akcase18/MQB_Monitor_Hardware/bom_production/MQBMonitor_v5.0.2_bom.csv

Designator | Footprint | Quantity | Value | LCSC Part #
C1, C12, C13, C17, C18, C21, C6, C9 | 0402 | 8 | 0.1uF | C1525
C10, C11, C2, C3 | 0603 | 4 | 10uF | C96446
C14, C15, C19, C20 | 0402 | 4 | 10uF | C15525
C16 | 0402 | 1 | 1uF | C52923
C4 | 1206 | 1 | 10uF | C13585
C5 | 0603 | 1 | 0.1uF | C14663
C7, C8 | 0805 | 2 | 22uF | C45783
D1, D2 | D_SMA | 2 | Diode | C8678
D3 | SOT95P230X110-3N | 1 | PESD1CAN,215 | C15771
IC1 | SOT95P280X100-5N | 1 | PAM2804AAB010 | C71463
J1 | AFC01S50FCA00 | 1 | AFC01-S50FCA-00 | C262676
J2 | JST_XH_B4B-XH-A_1x04_P2.50mm_Vertical | 1 | 4-Pin to Car | N/A
L1 | 1008 | 1 | 4.7uH | C5832360
L2 | L_Changjiang_FNR5040S | 1 | 15uH | C167969
R1 | 0402 | 1 | 100k | C25741
R10, R11, R12, R7, R8 | 0402 | 5 | 10k | C25744
R2 | 0603 | 1 | 1R | C22936
R3 | 0603 | 1 | 10R | C22859
R4, R5 | 0402 | 2 | 5.1k | C25905
R6 | 0402 | 1 | 51k | C25794
R9 | 0603 | 1 | 1k | C21190
S1, S2 | SW_PTS526_SM08_SMTR2_LFS | 2 | Push Button | C2689521
U1 | U_SOT-23_TEX | 1 | PLMR54410DBVR | C3200265
U2 | SOT-223-3_TabPin2 | 1 | AMS1117-3.3 | C6186
U3 | ESP32-S3-WROOM-1 | 1 | ESP32-S3-WROOM-1 | C2913205
U4 | SOIC-8_3.9x4.9mm_P1.27mm | 1 | SN65HVD230 | C12084
USB1 | USB_C_Receptacle_G-Switch_GT-USB-7010ASV | 1 | USB-C Port | C2988369
