akcase18/MQB_Monitor_Hardware/enclosure/Display Case - Main Case.stl

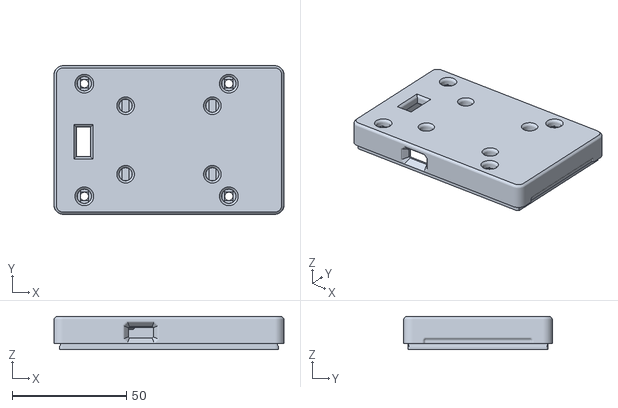
[picture p1: CAD file, 2026-11-13]
enclosure/Display Case - Main Case.stl
100.8 x 65.1 x 14.6
