akcase18/MQB_Monitor_Hardware/3d_models/MQBMonitor_v5_0_2.step

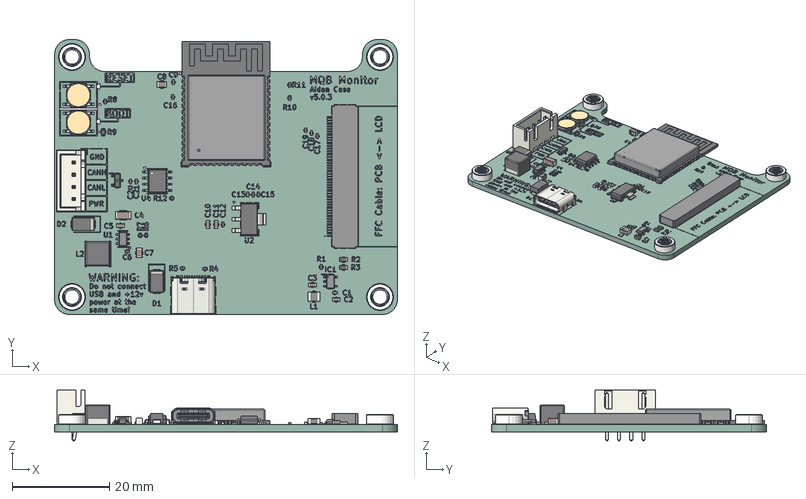
[picture p2: CAD file, 2026-11-11]
3d_models/MQBMonitor_v5_0_2.step
70.5 x 56.5 x 10.4 mm
C_0603_1608Metric x 5
C_0402_1005Metric x 13
R_0603_1608Metric x 3
D_SMA x 2
PinsArrayL
PinsArrayR
PTS526 SM08 SMTR2 LFS x 2
L_Changjiang_FNR5040S
SOIC-8_3.9x4.9mm_P1.27mm
R_0402_1005Metric x 9
BODY-SOT
LEAD-SOT x 6
SOT-223
C_0805_2012Metric x 2
SOT23 lower body
SOT23 Lead x 3
SOT23 Upper body
C_1206_3216Metric
Pins
JST_B4B_XH_A
ESP32-S3-WROOM-1
USB_C_Receptacle_16P_TopMnt_Horizontal_GCT_USB4105-xx-A
L_1008_2520Metric
MQB_Monitor_silkscreen
MQB_Monitor_PCB
