akcase18/MQB_Monitor_Hardware/enclosure/Display Case - Face Plate.stl

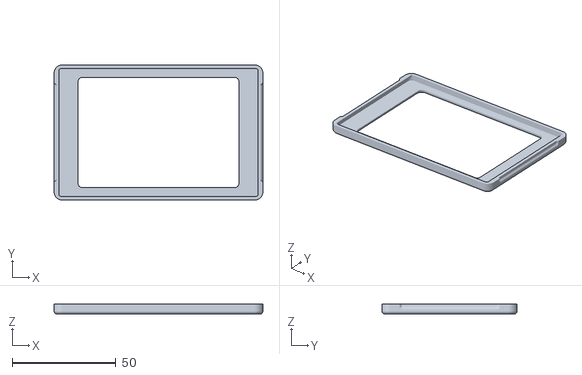
[picture p3: CAD file, 2026-11-13]
enclosure/Display Case - Face Plate.stl
100.8 x 65.1 x 5.00
