akcase18/MQB_Monitor_Hardware/(list of files, cad)

Other CAD files:
3d_models/MQBMonitor_v5_0_1.step
3d_models/MQBMonitor_v4.step
