akcase18/MQB_Monitor_Hardware/schematic_layout_pdfs/MQB_Monitor_Schematic_v5_1_0.pdf

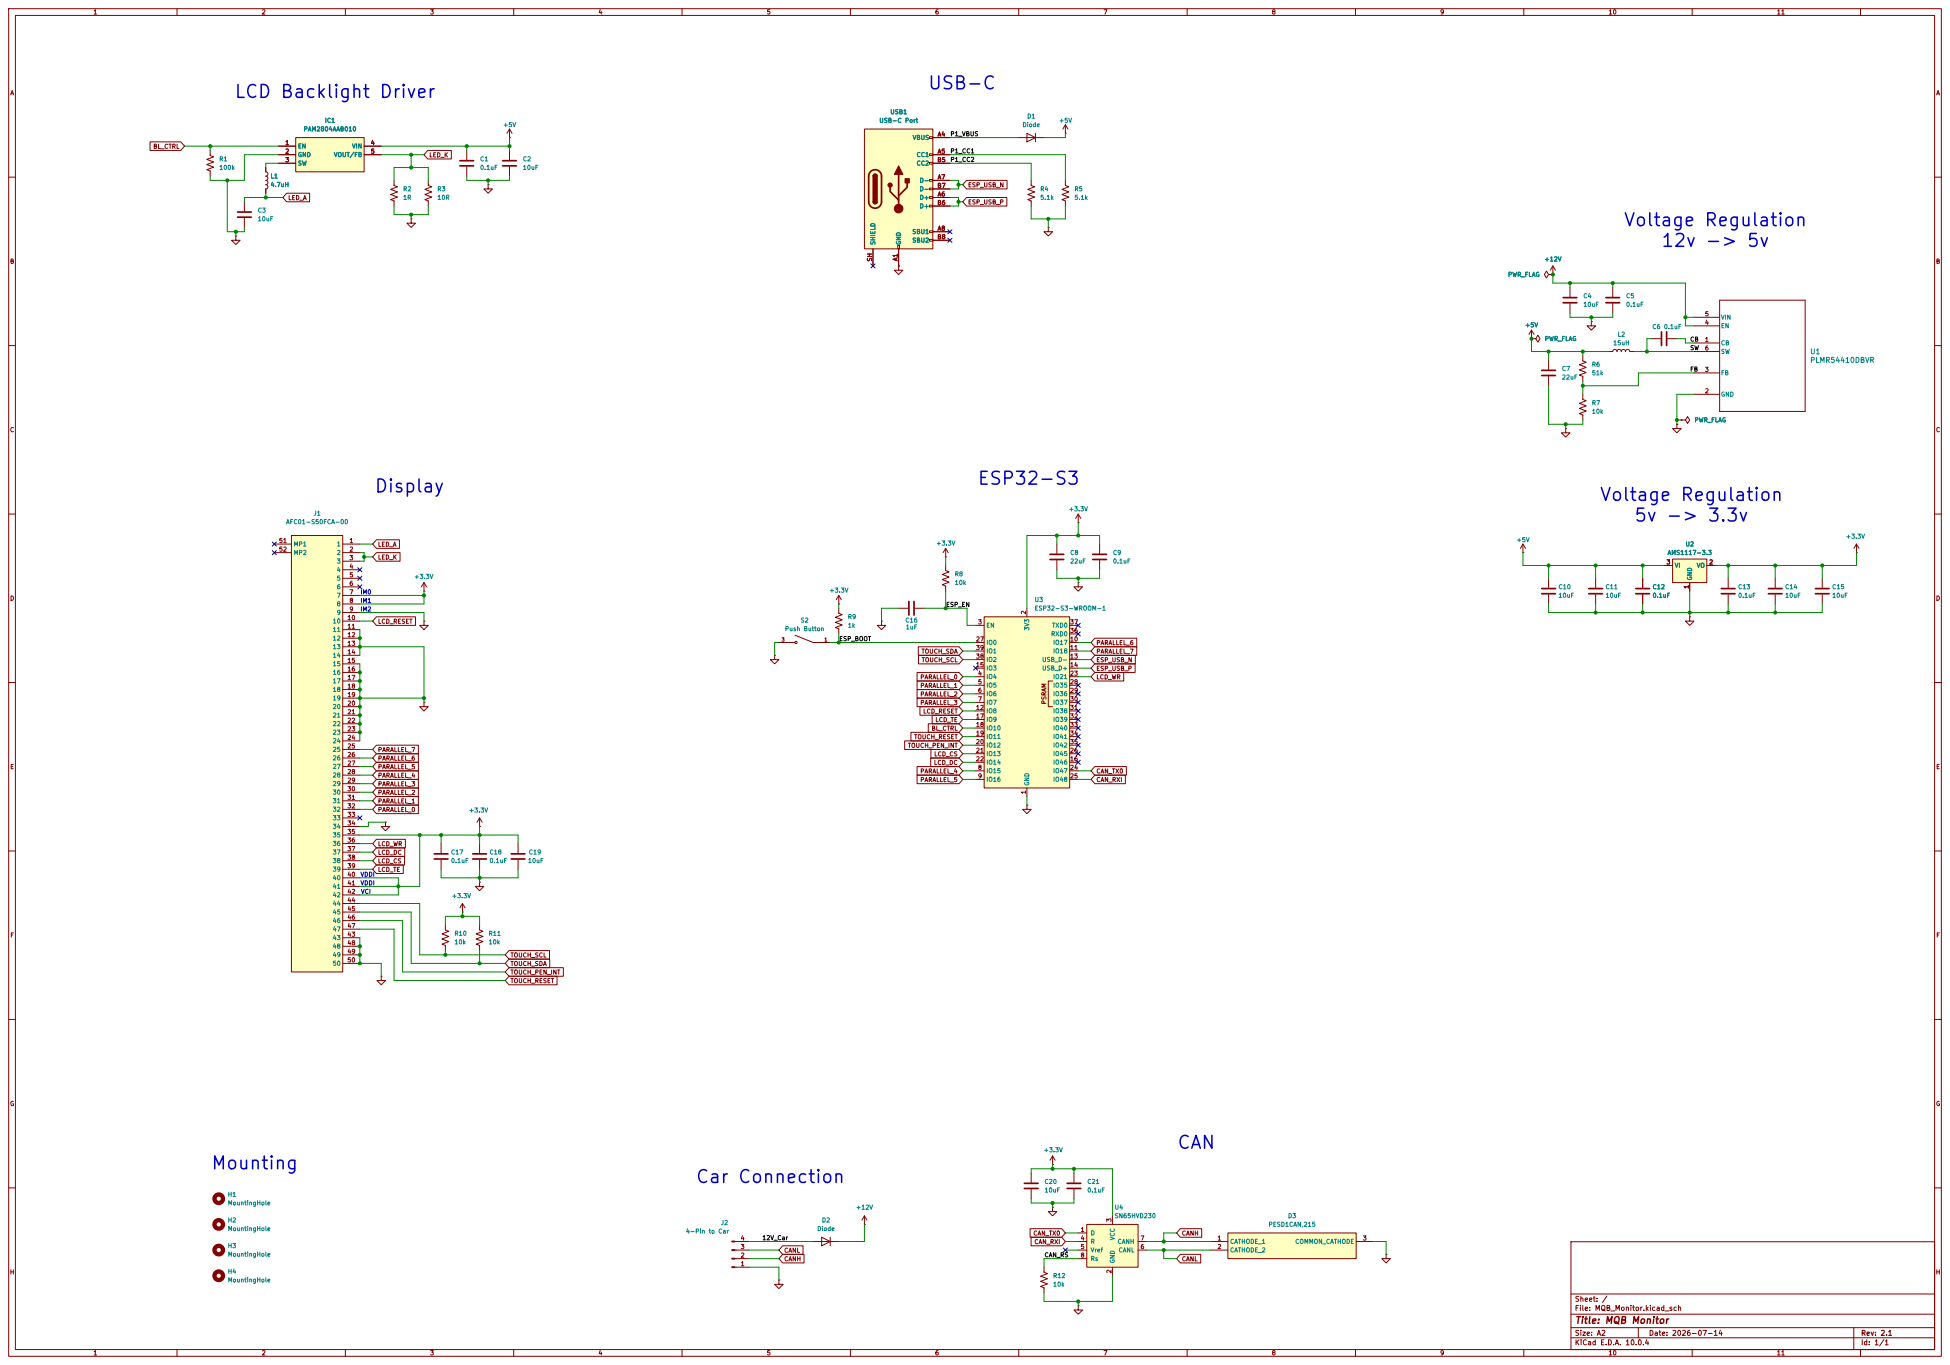
[picture p4: page 1]

Size: A2 | Rev: 2.1
KiCad E.D.A. 10.0.4 | Id: 1/1
