akcase18/MQB_Monitor_Hardware/schematic_layout_pdfs/MQB_Monitor_Layout_v5_1_0.pdf

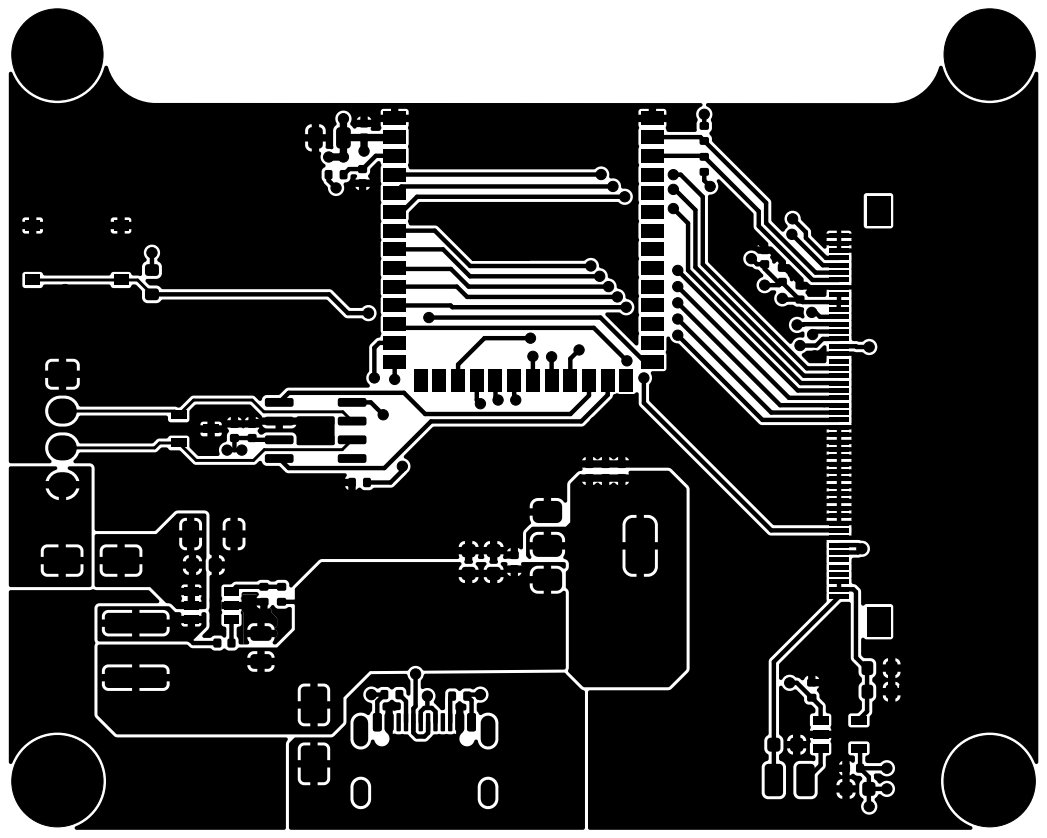
[picture p5: page 1]

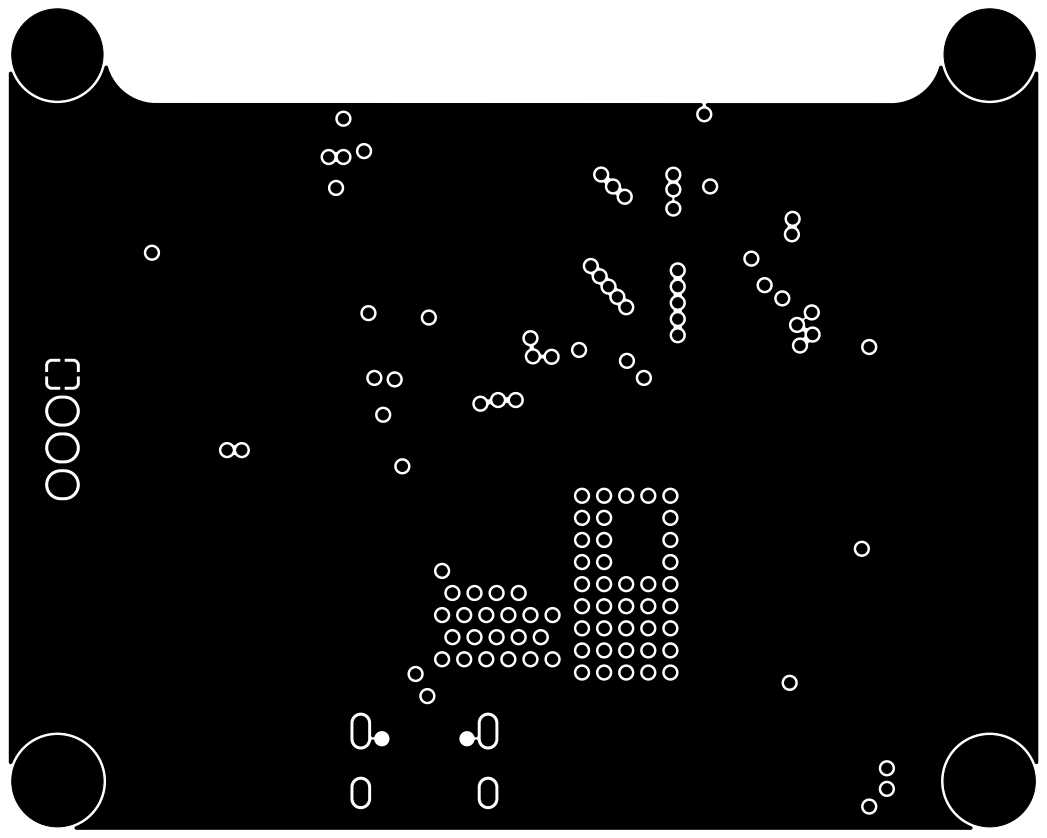
[picture p6: page 2]

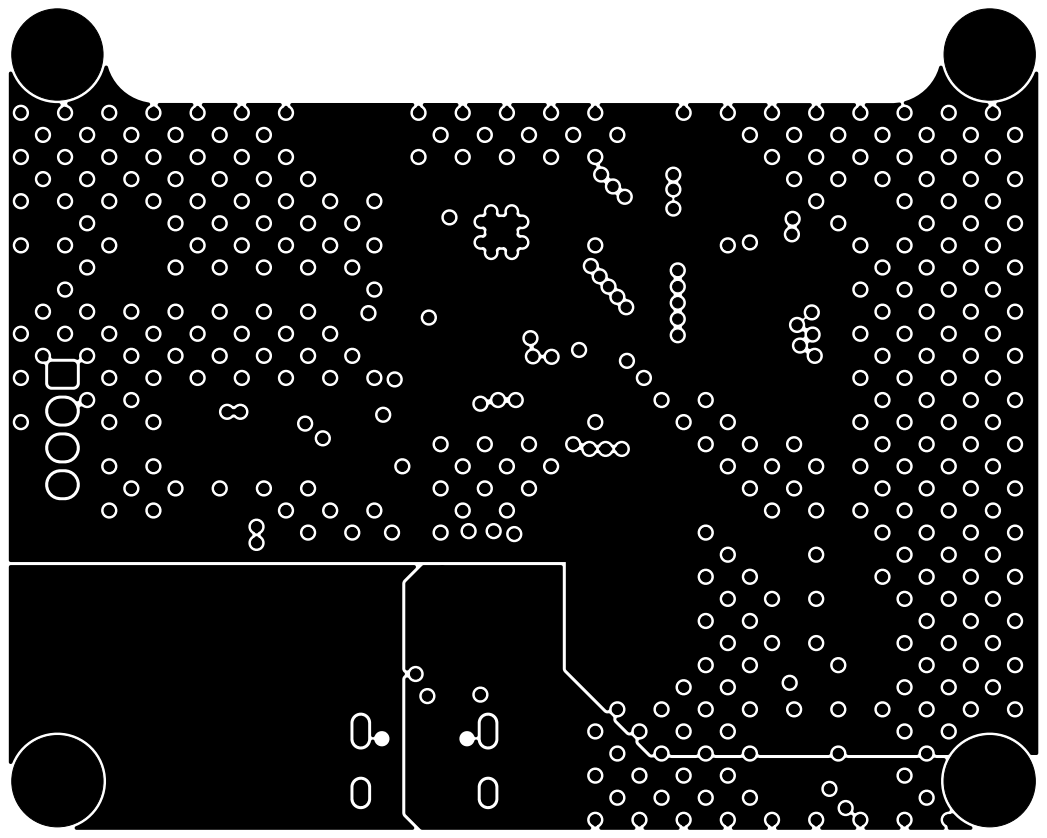
[picture p7: page 3]

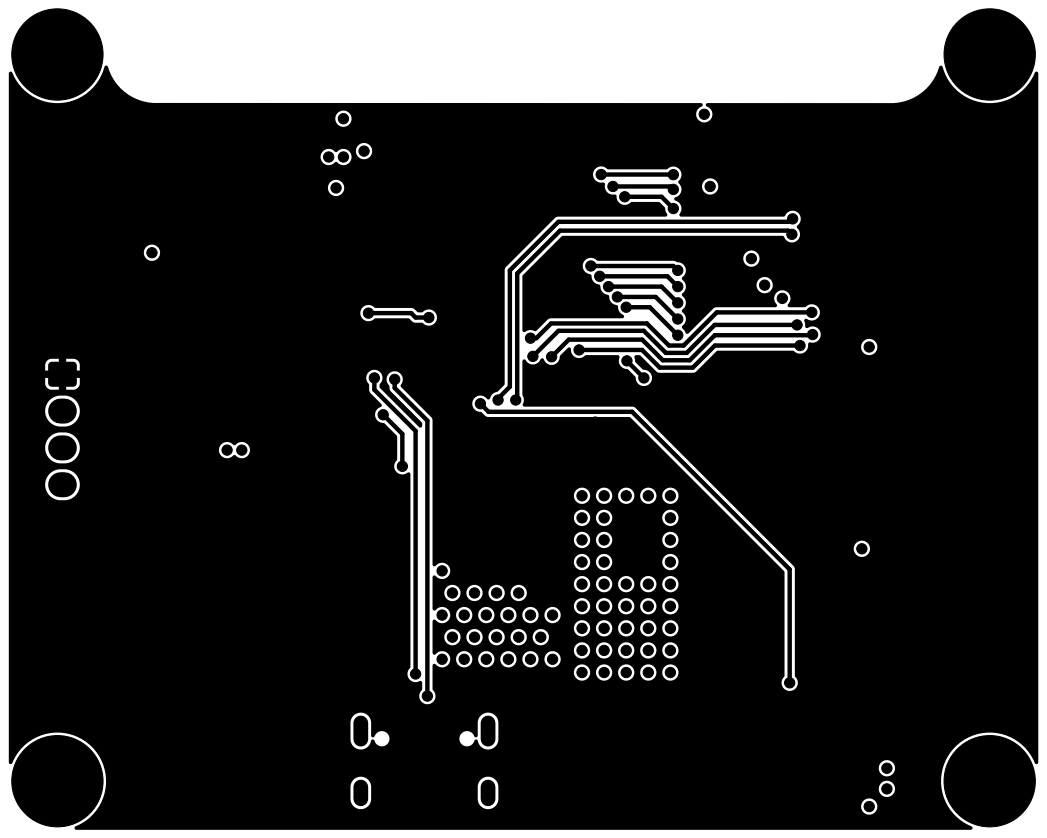
[picture p8: page 4]

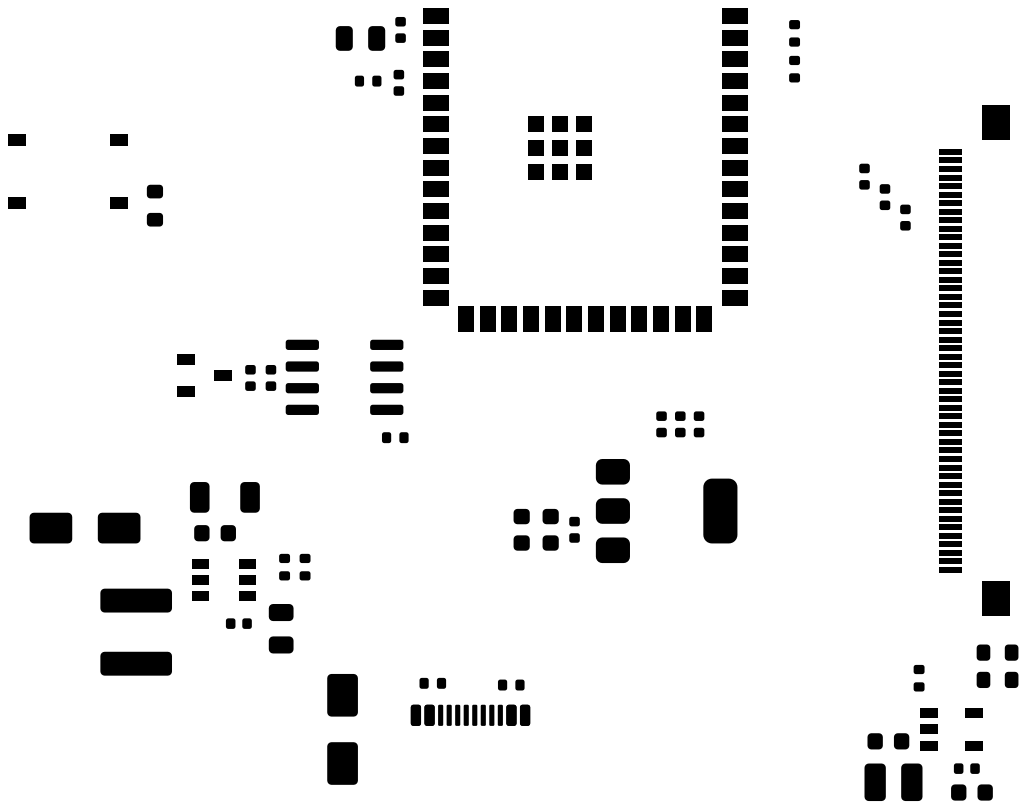
[picture p9: page 5]

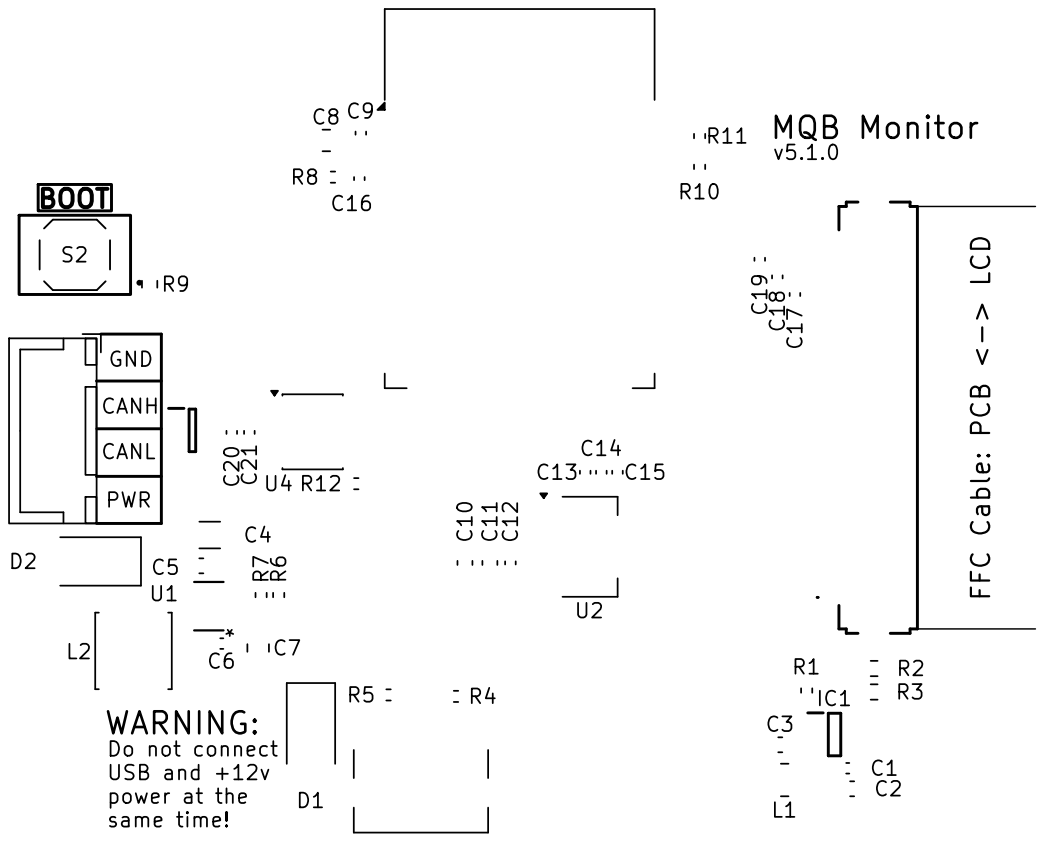
[picture p10: page 7]

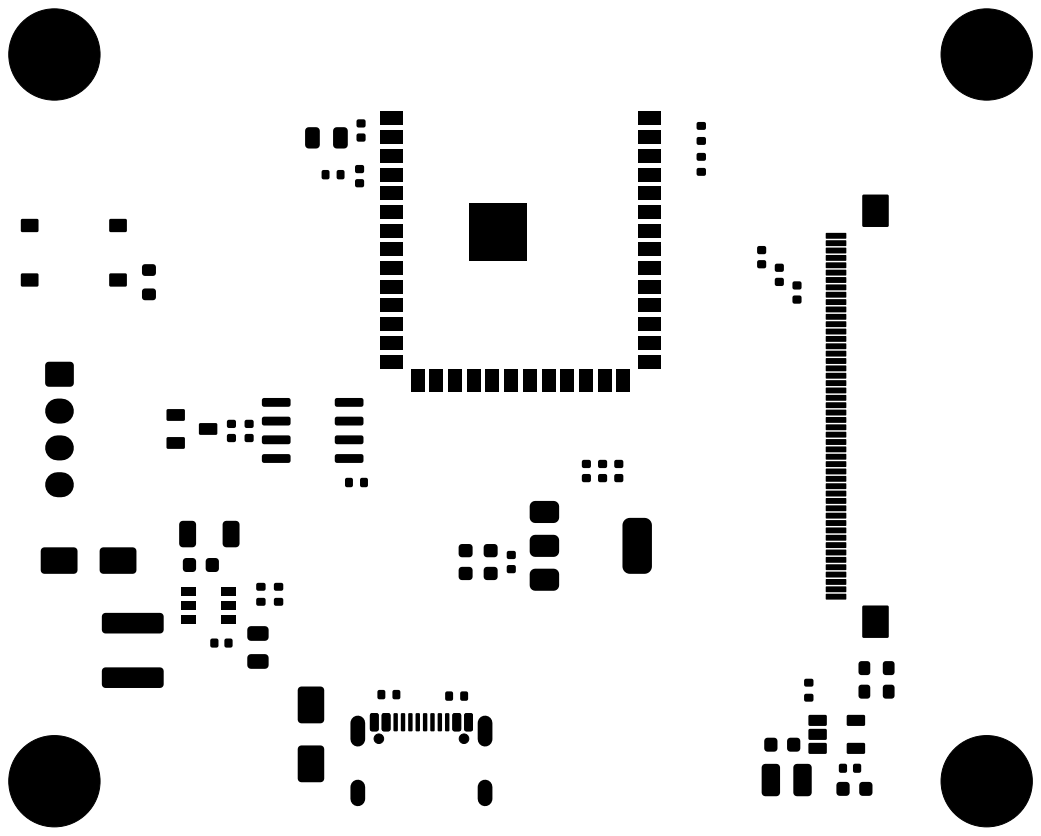
[picture p11: page 9]

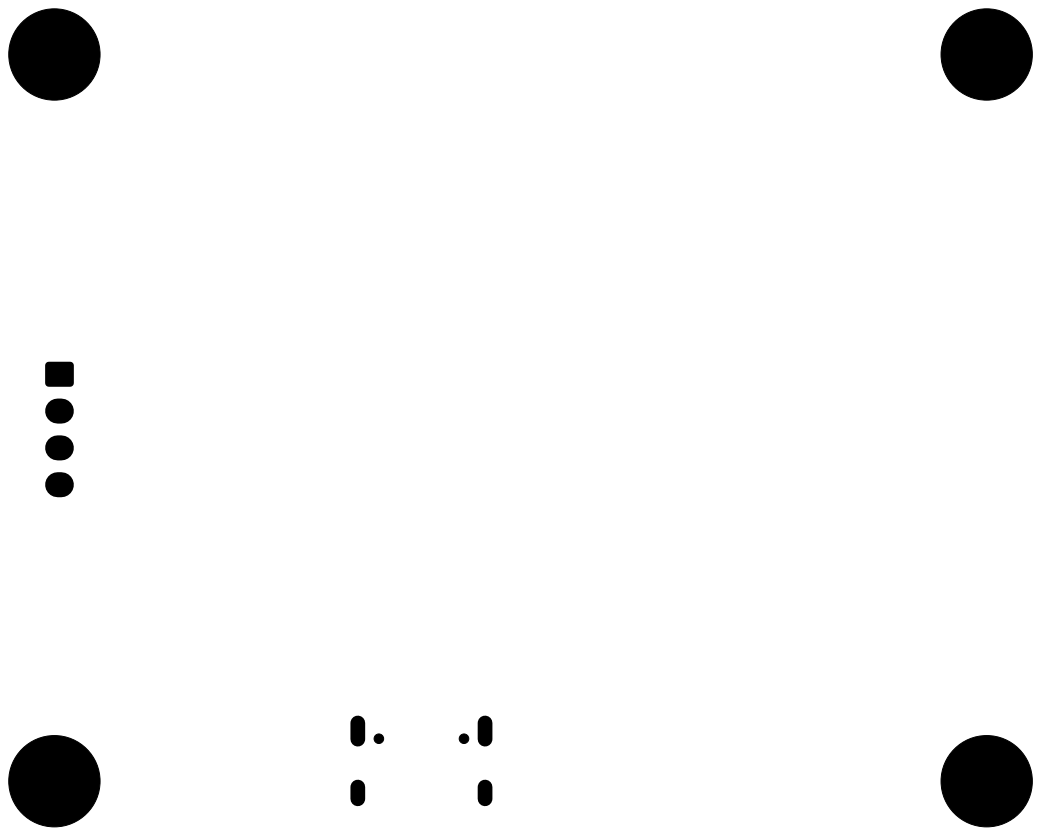
[picture p12: page 10]

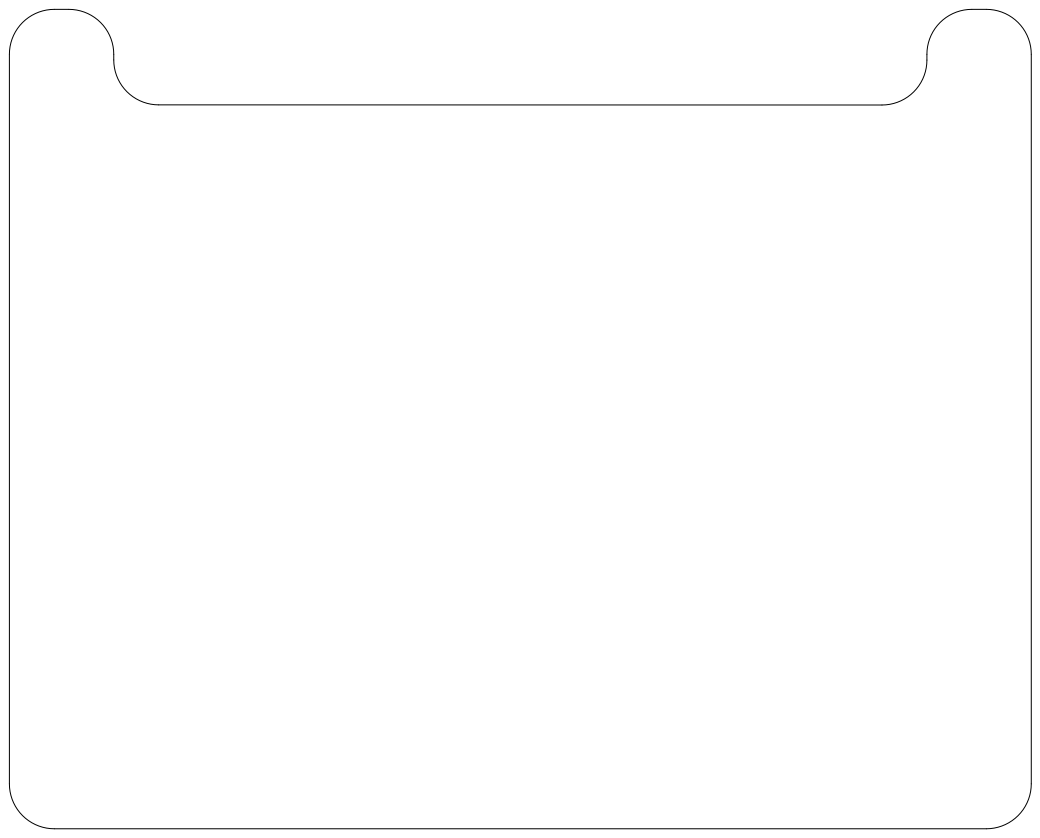
[picture p13: page 11]
