akcase18/MQB_Monitor_Hardware/schematic_layout_pdfs/MQB_Monitor_Layout_v5_0_2.pdf

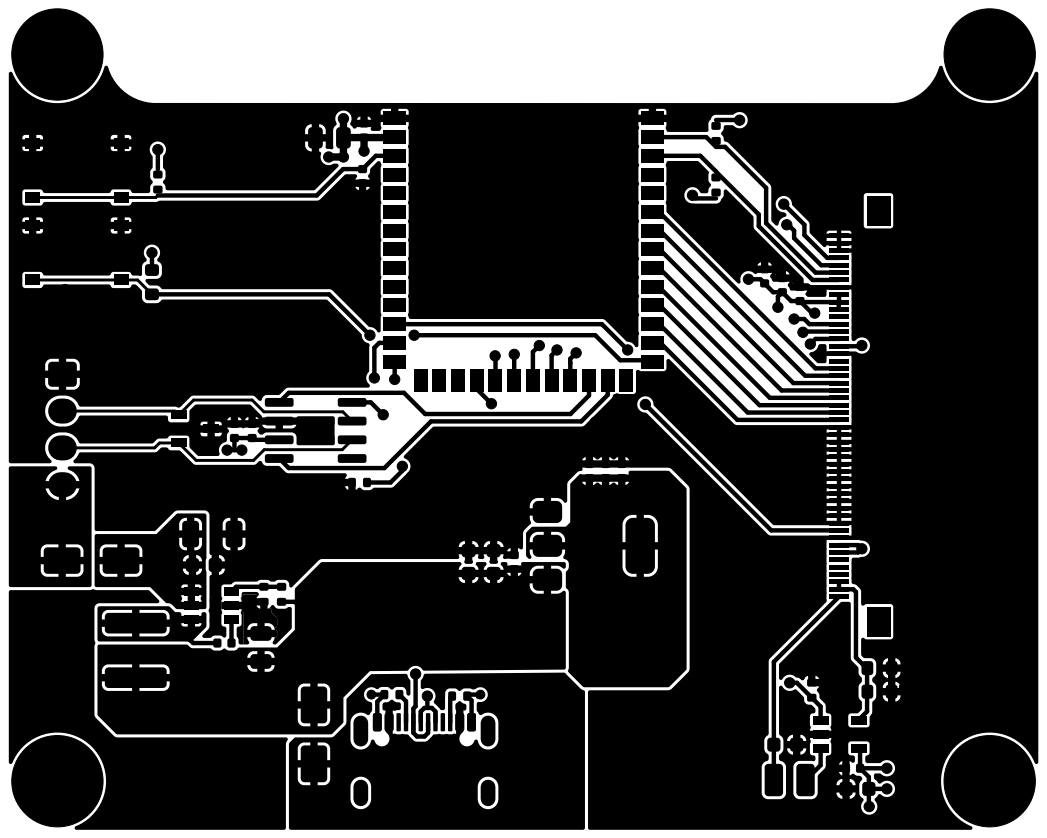
[picture p14: page 1]

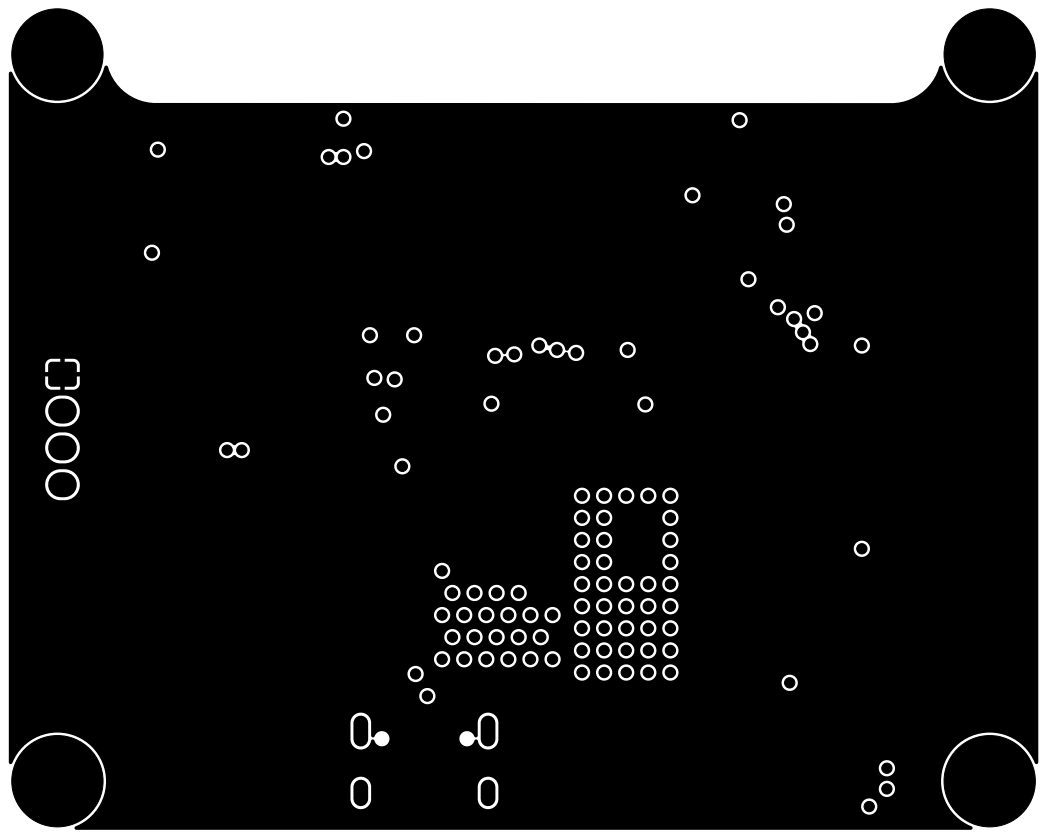
[picture p15: page 2]

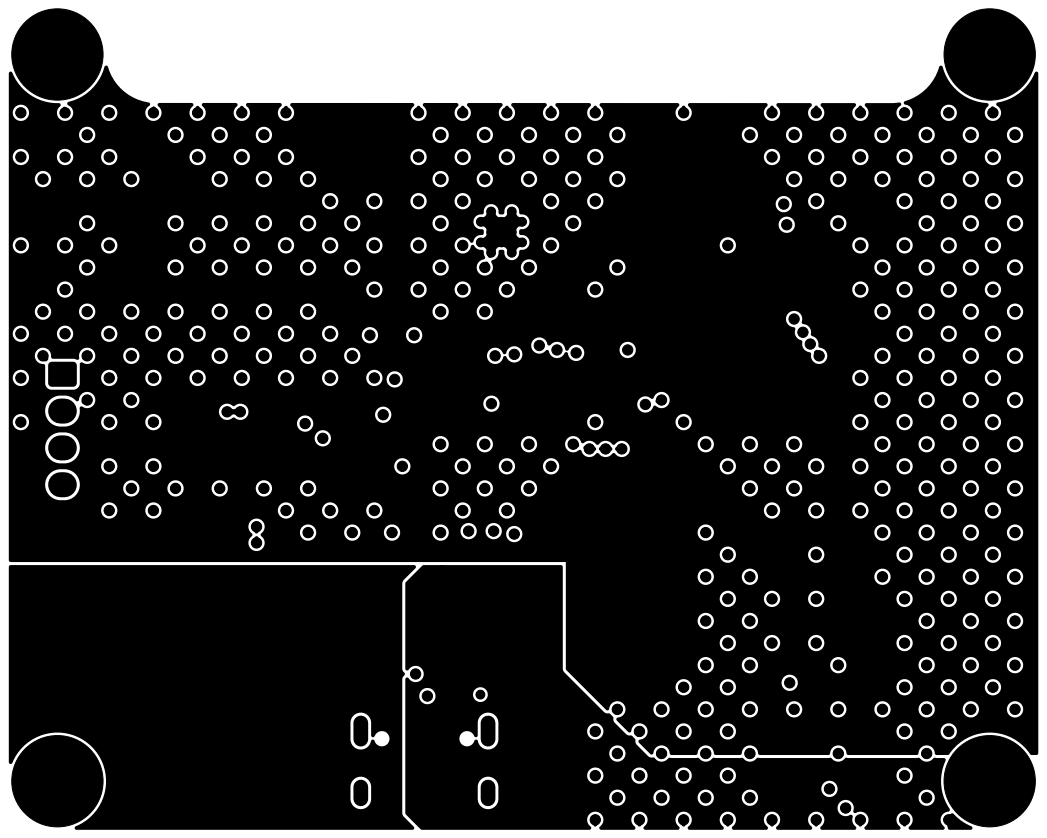
[picture p16: page 3]

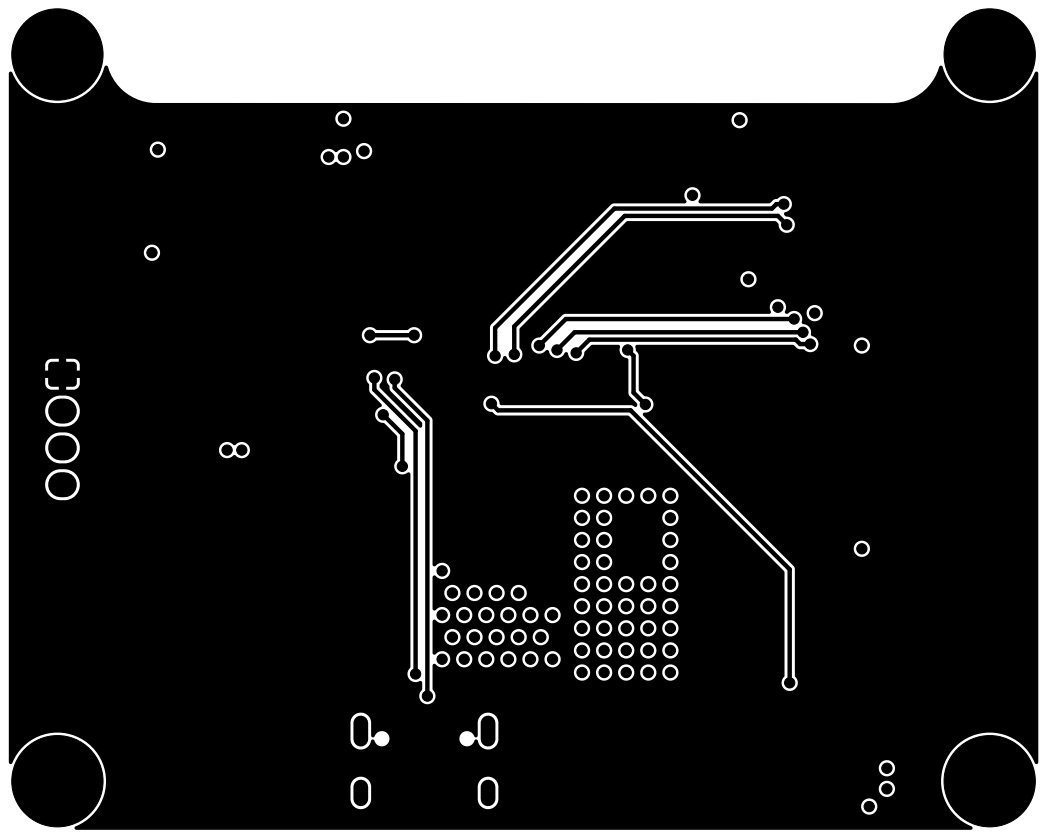
[picture p17: page 4]

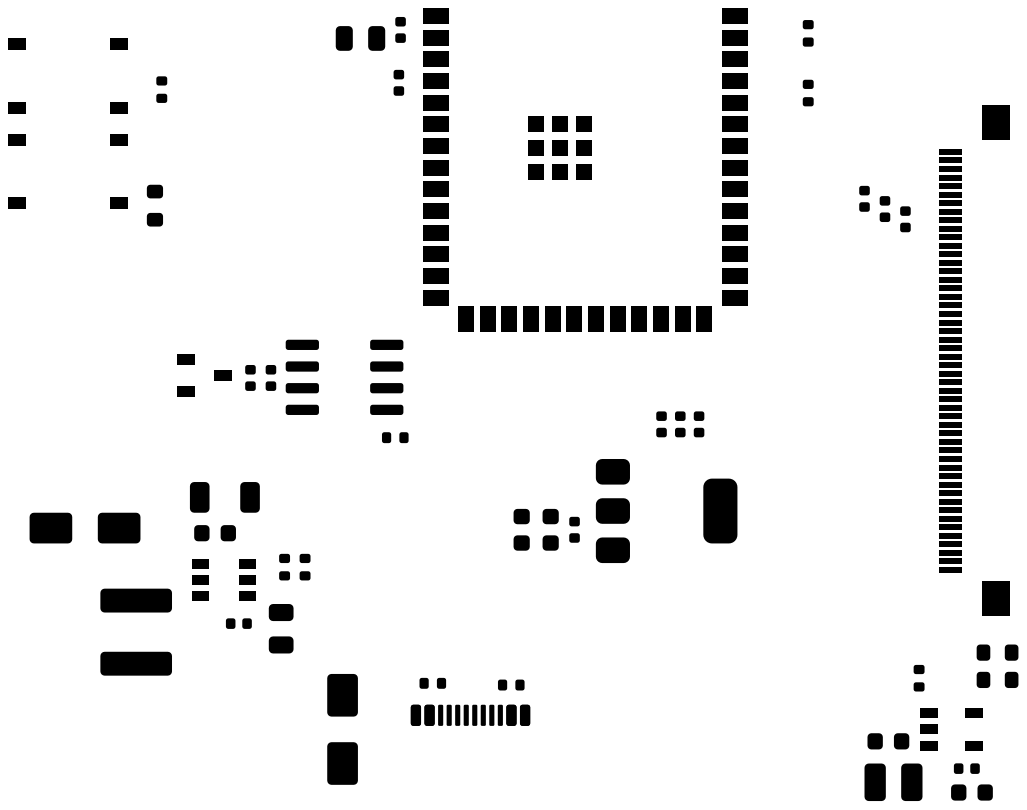
[picture p18: page 5]

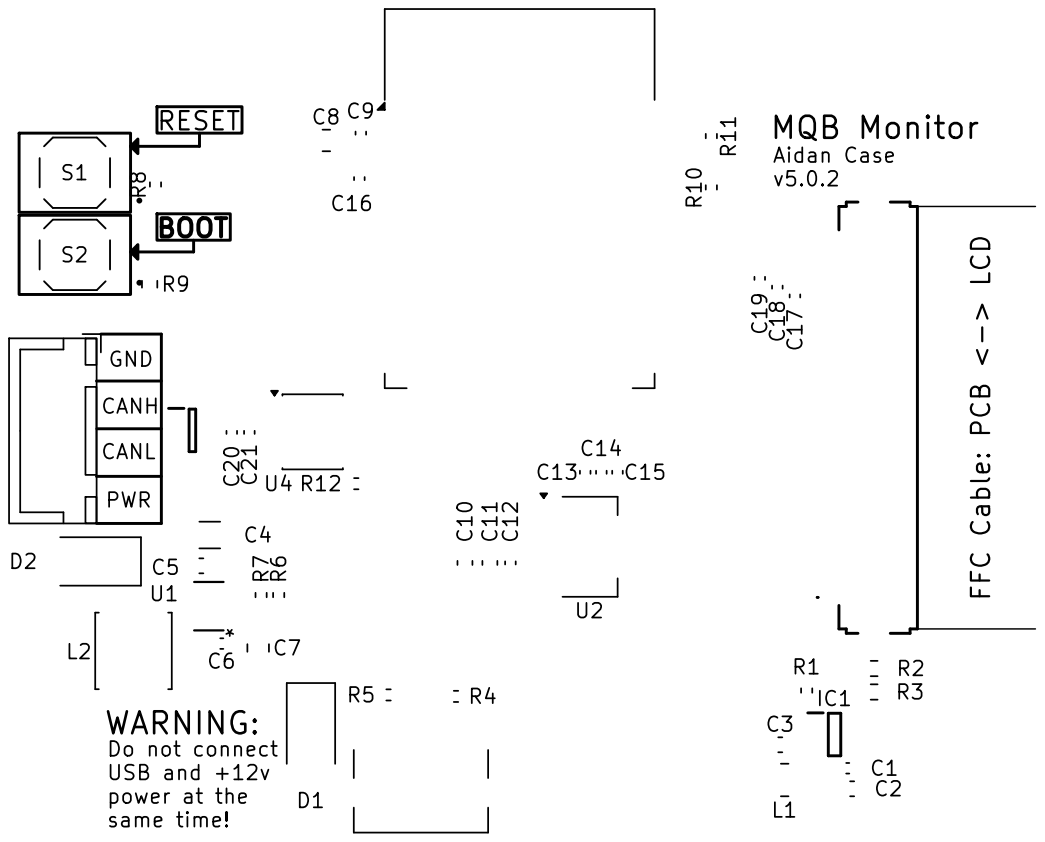
[picture p19: page 7]

MQB Monitor C8 U1
Do not connect USB and +12v power at the same time! GND

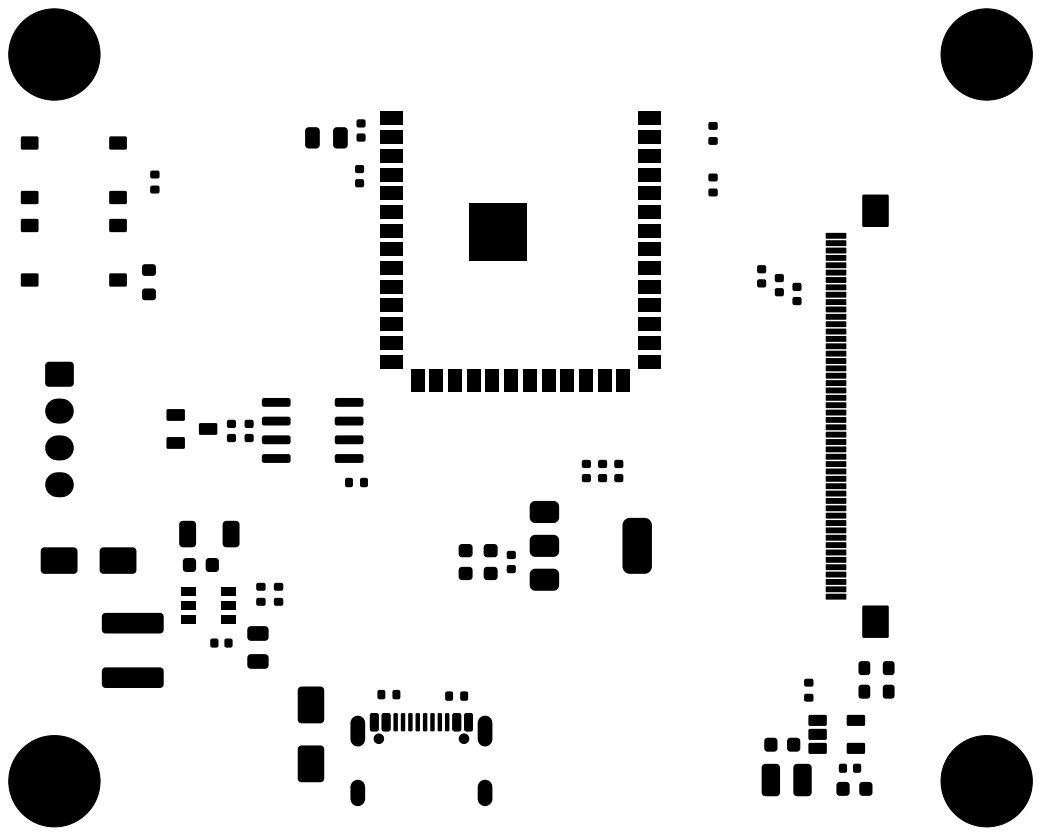
[picture p20: page 9]
