akcase18/MQB_Monitor_Hardware/schematic_layout_pdfs/MQB_Monitor_Schematic v5_0_2.pdf

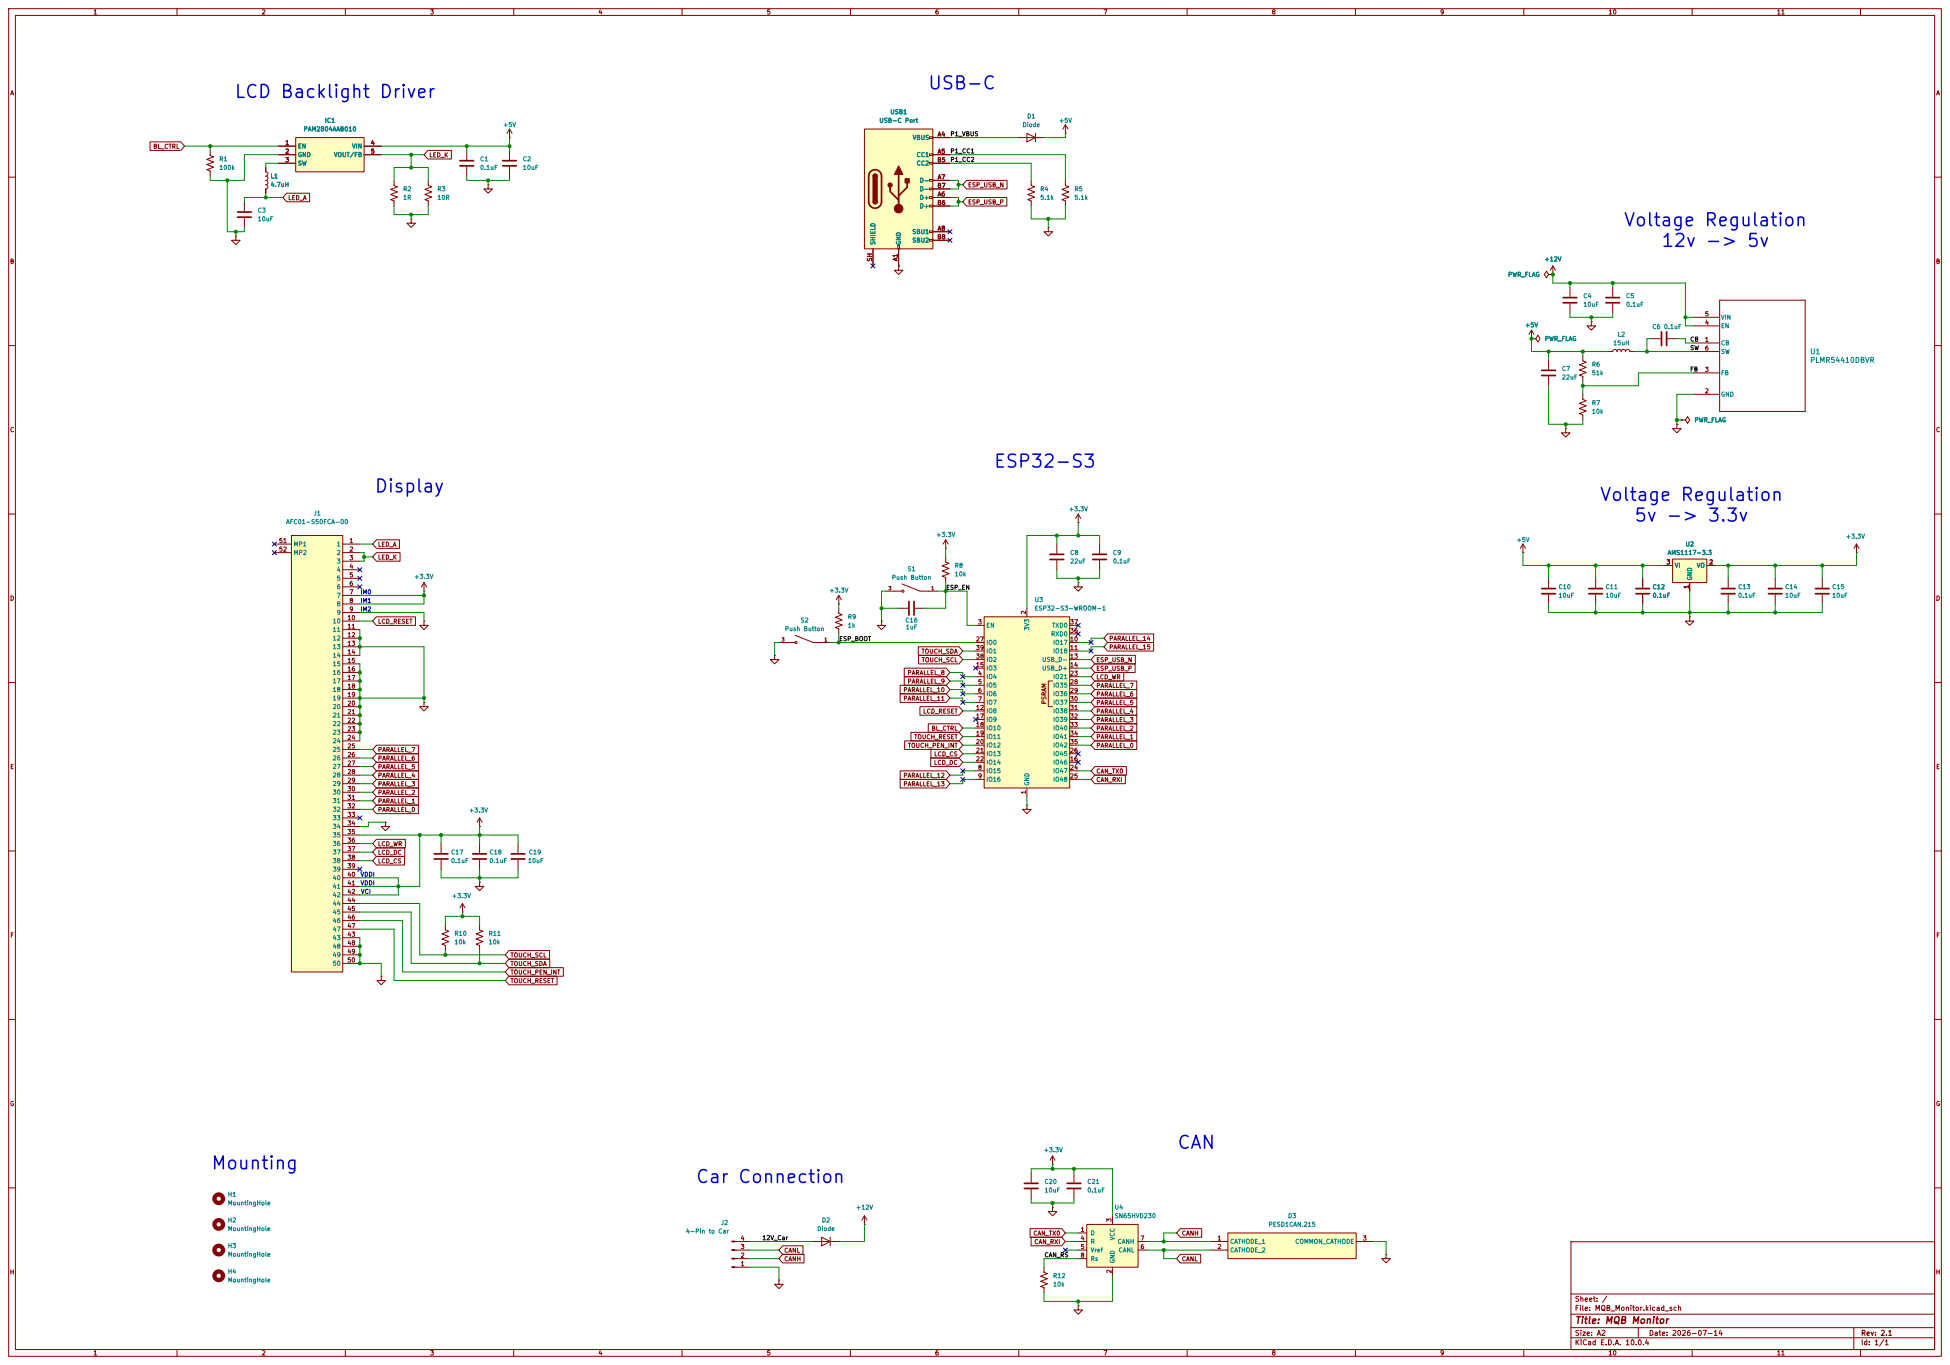
[picture p21: page 1]

Size: A2 | Rev: 2.1
KiCad E.D.A. 10.0.4 | Id: 1/1
