akcase18/MQB_Monitor_Hardware/schematic_layout_pdfs/MQB_Monitor_Layout.pdf

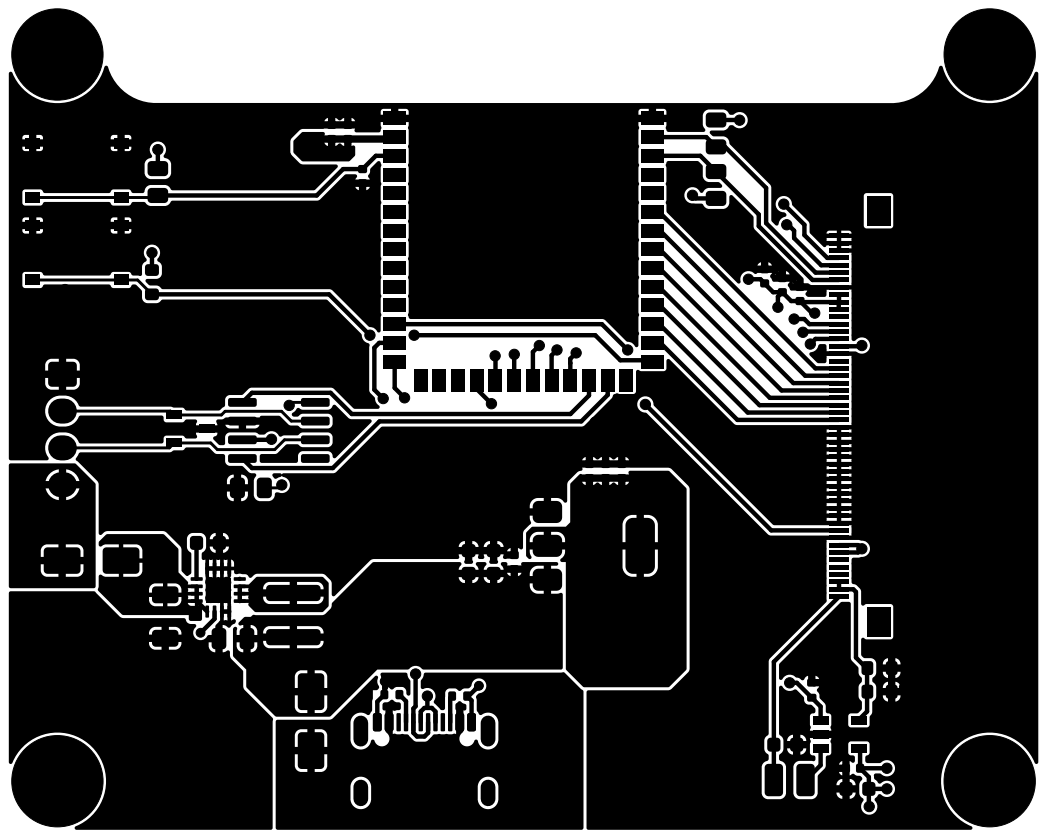
[picture p22: page 1]

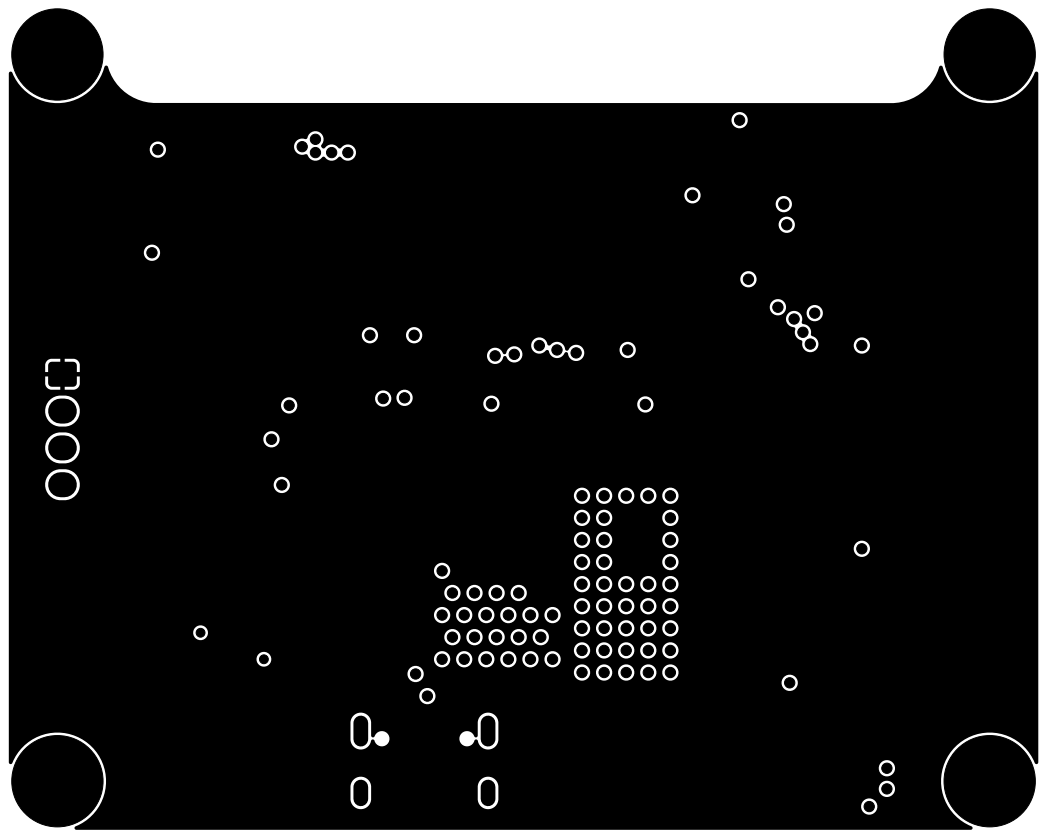
[picture p23: page 2]

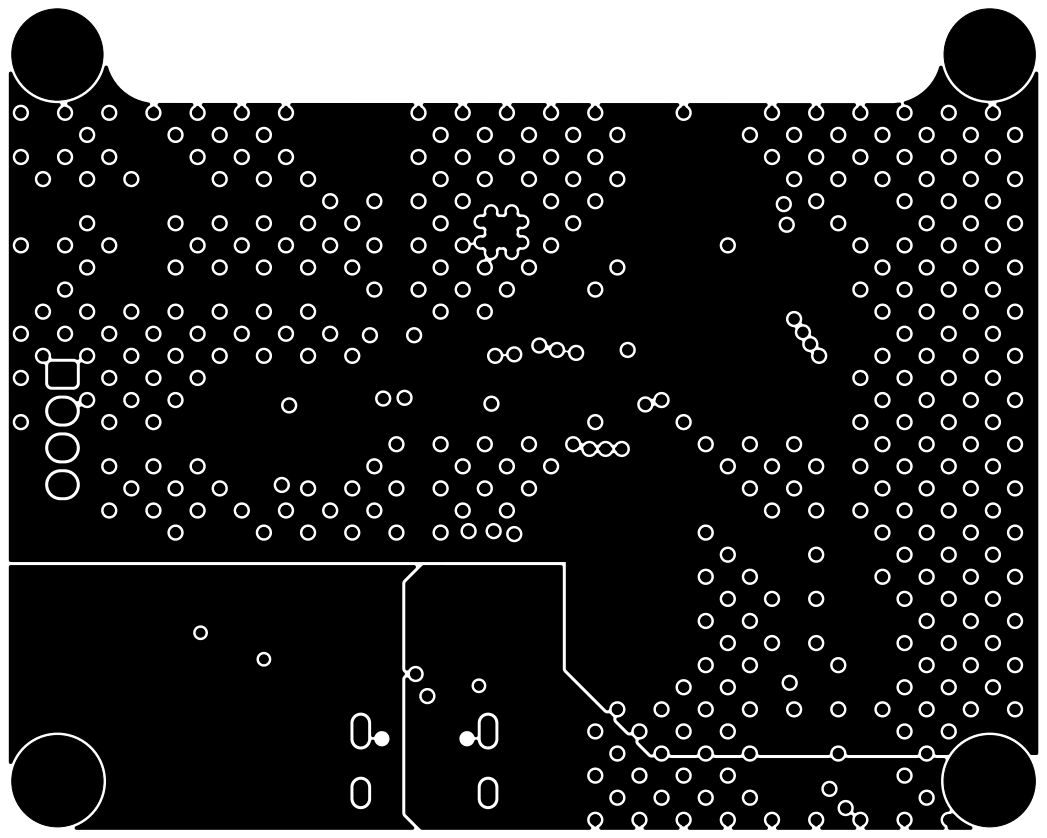
[picture p24: page 3]

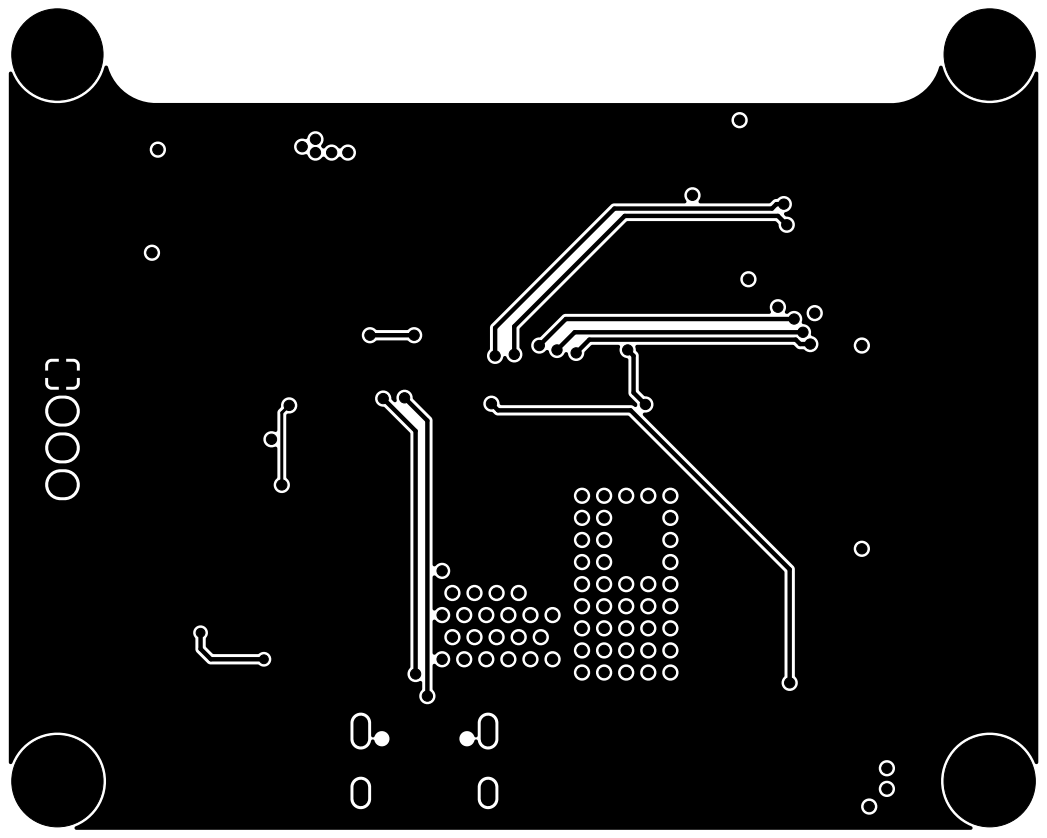
[picture p25: page 4]

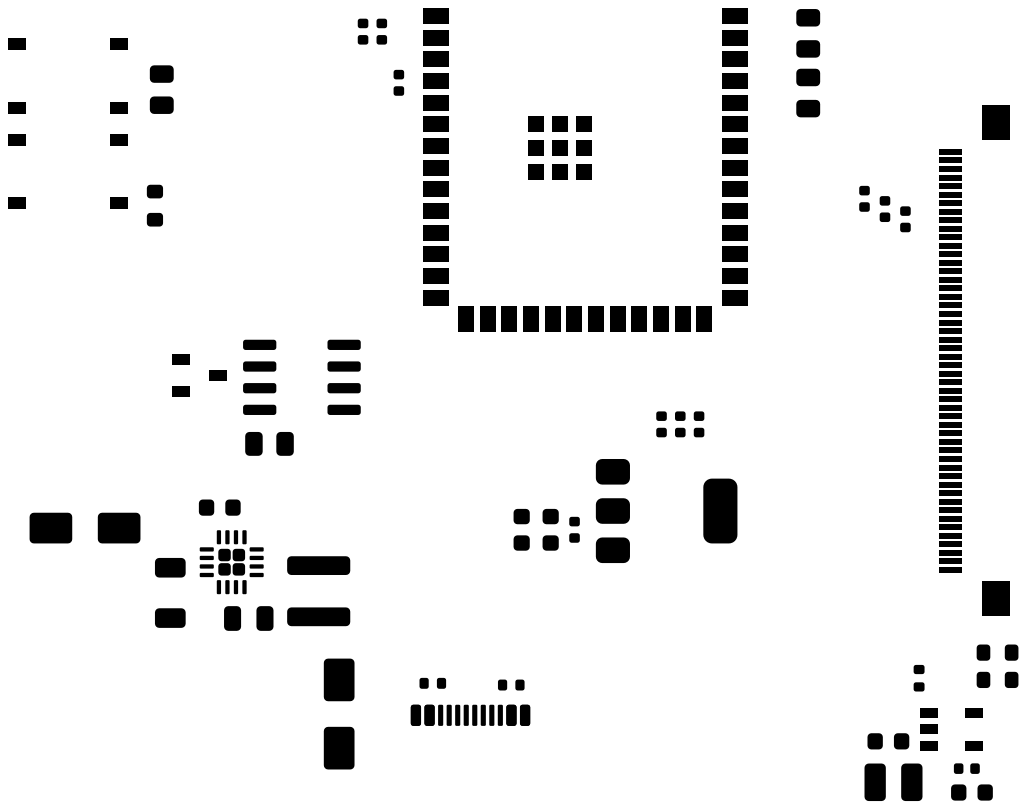
[picture p26: page 5]

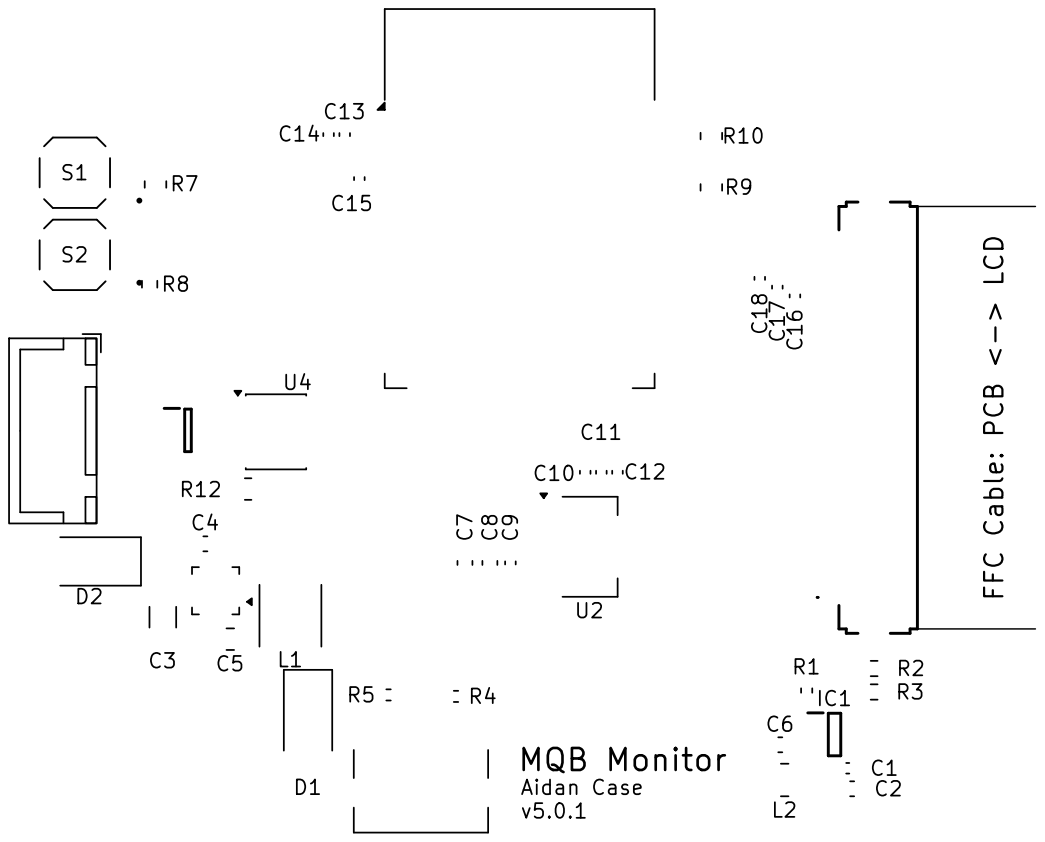
[picture p27: page 7]

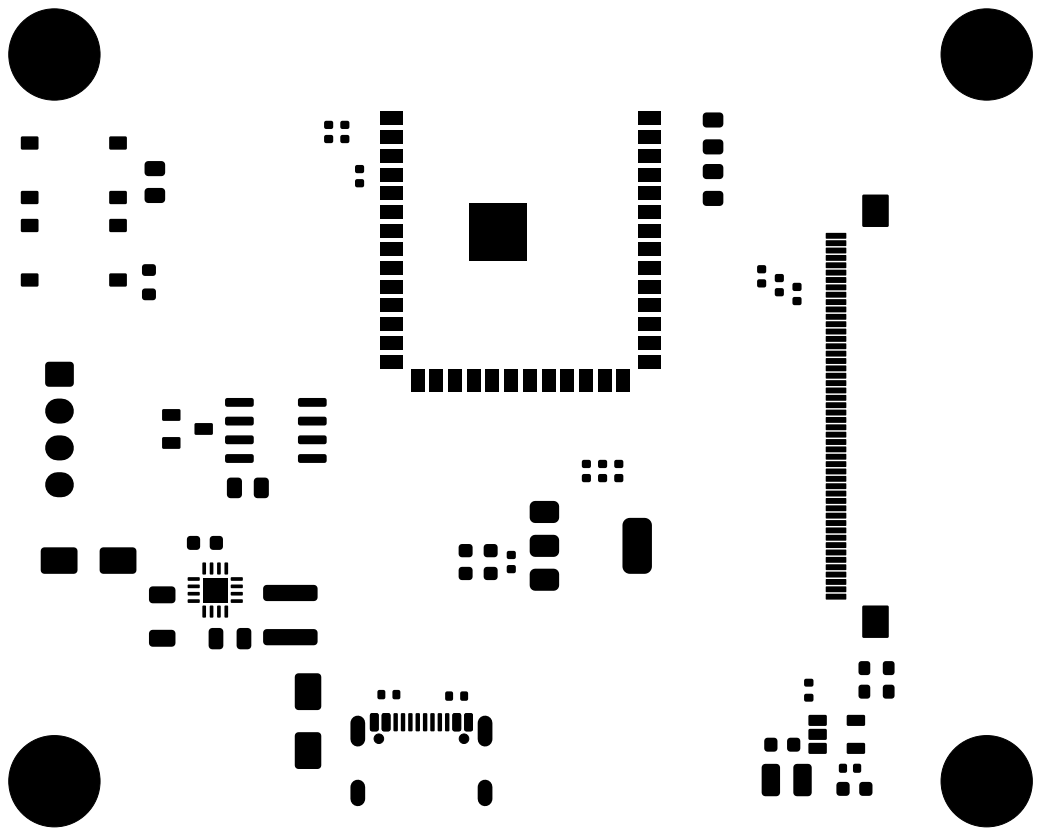
[picture p28: page 9]
