akcase18/MQB_Monitor_Hardware/MQB_Monitor.kicad_pcb

## KiCad design MQB_Monitor.kicad_pcb (2026-11-13)

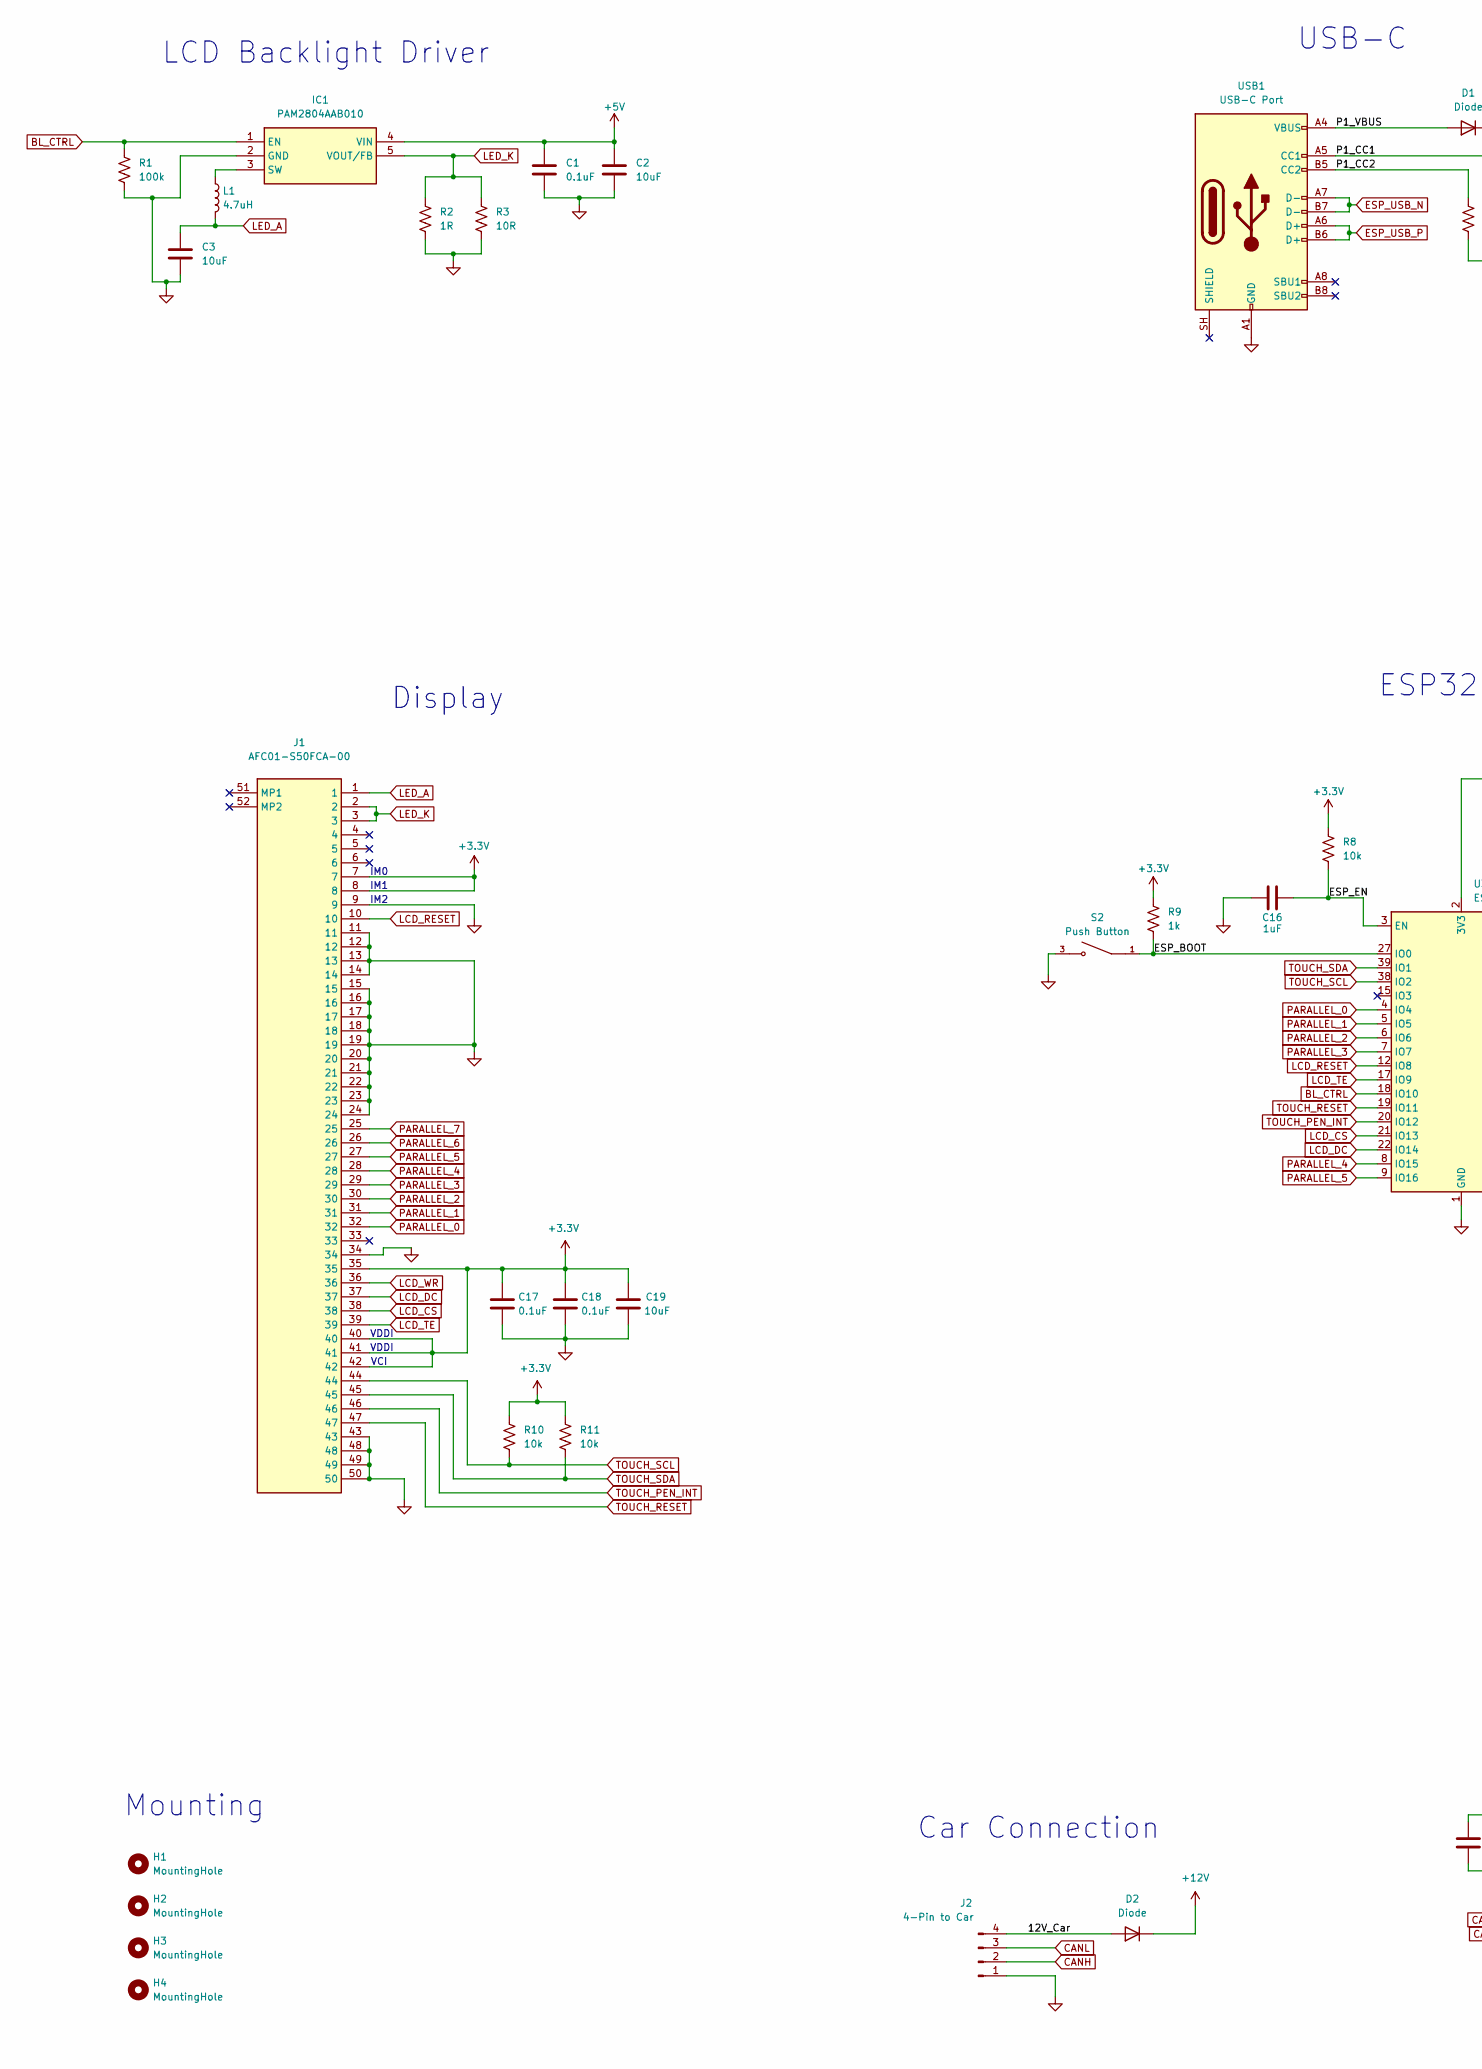
[picture p29: schematic MQB_Monitor.kicad_sch, MQB Monitor, part in row 1, column 1]

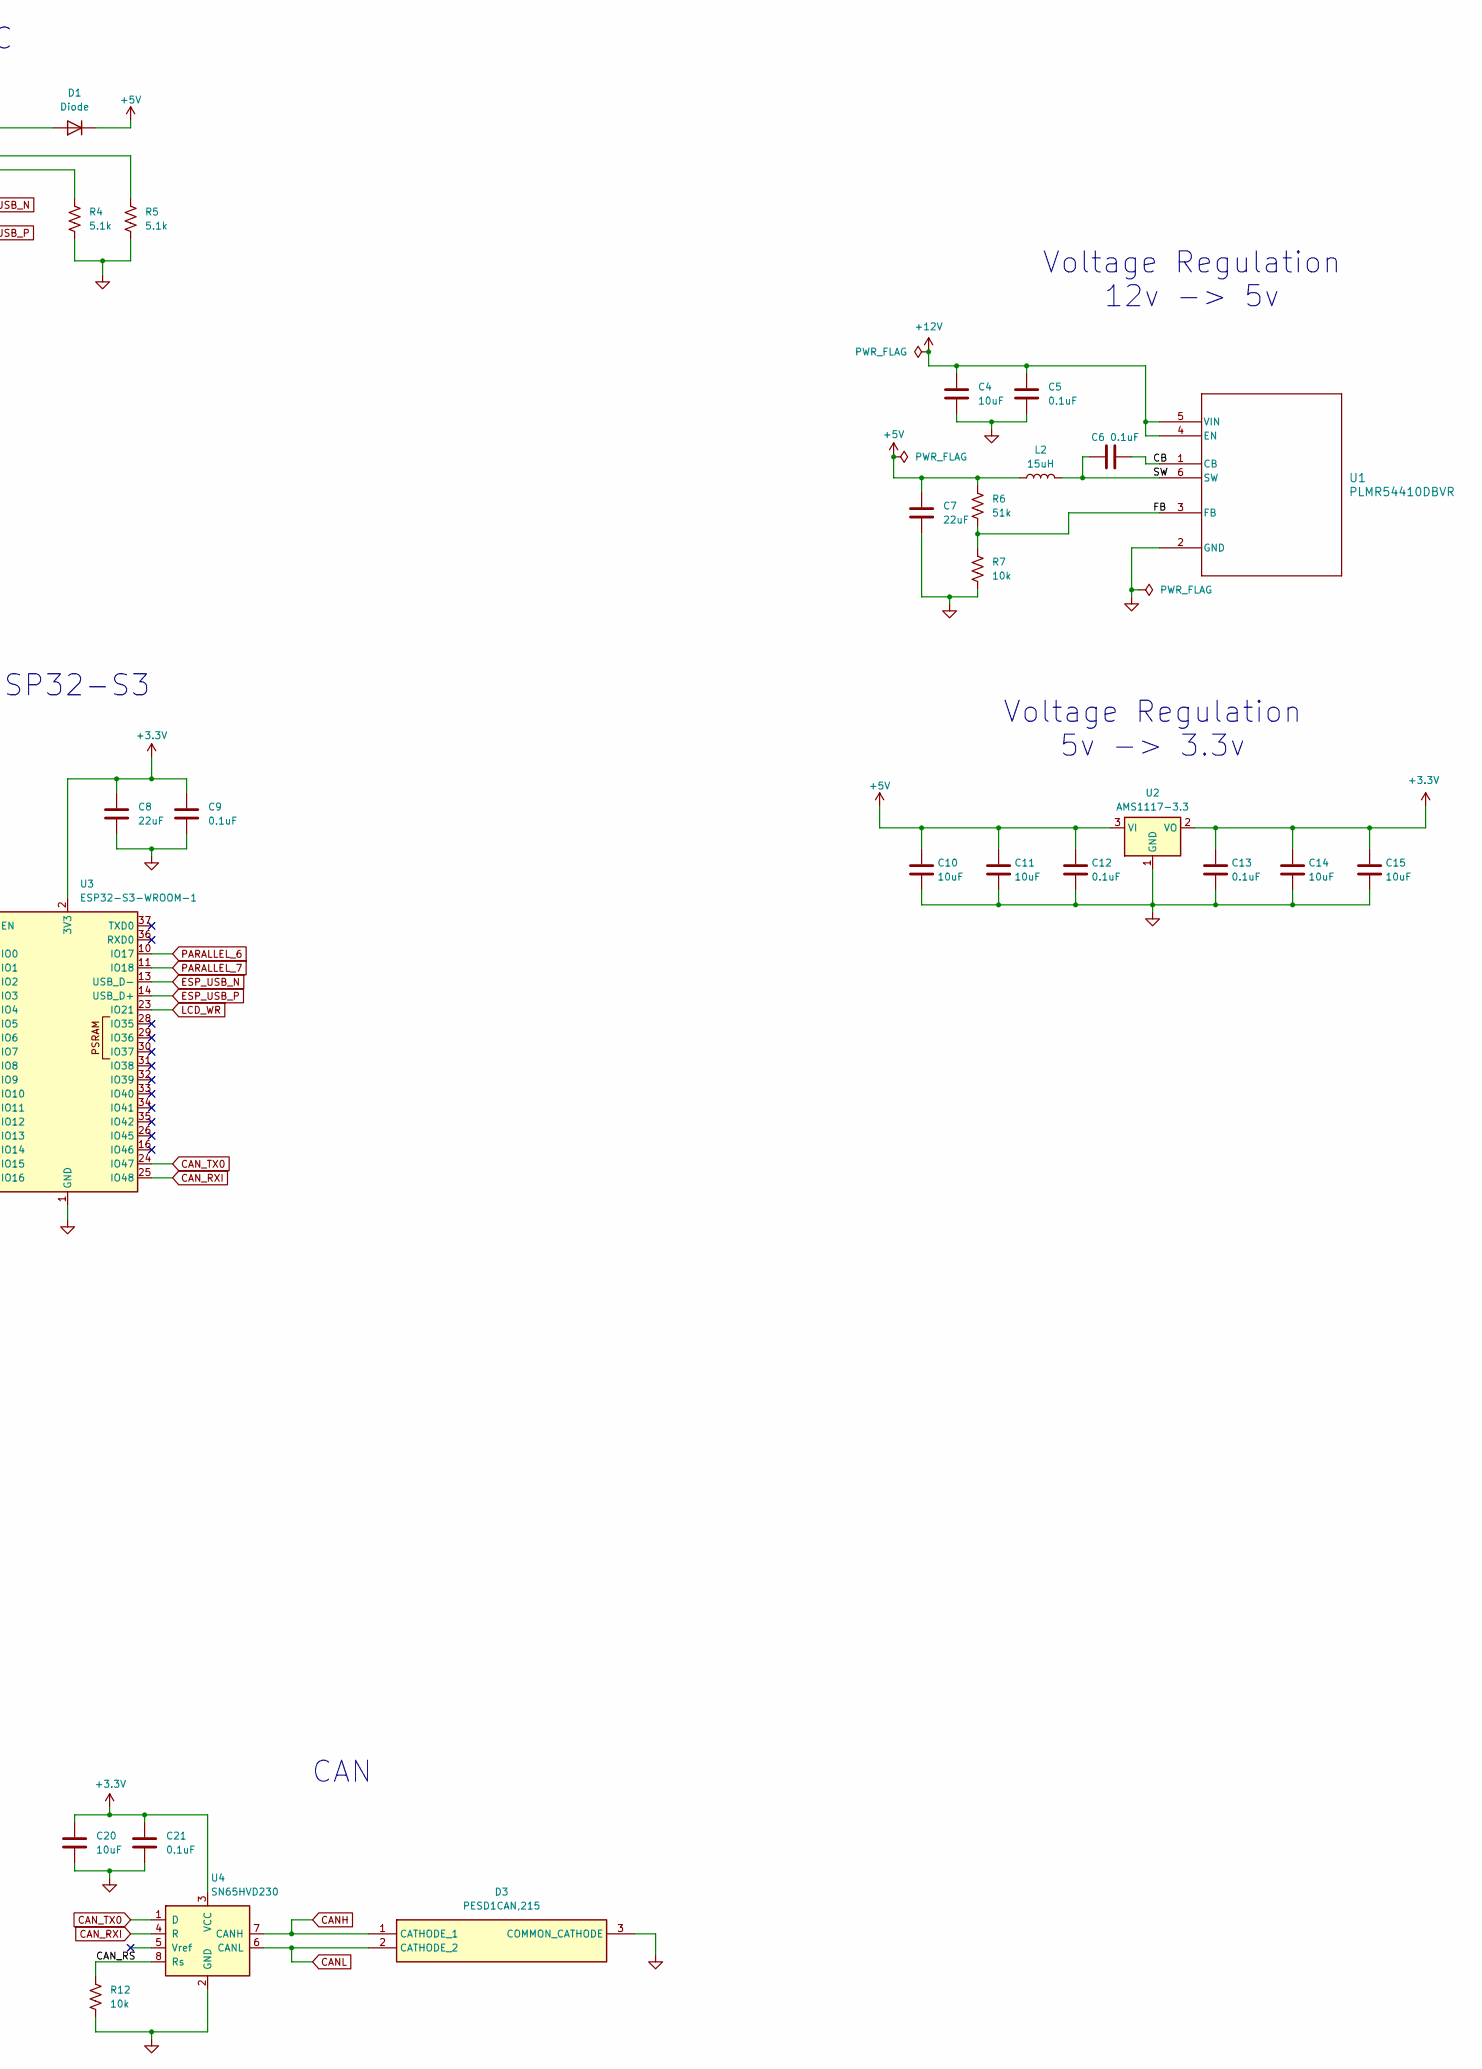
[picture p30: schematic MQB_Monitor.kicad_sch, MQB Monitor, part in row 1, column 2]

Parts:
C1, C6, C9, C12, C13, C17, C18, C21: 0.1uF; C_0402_1005Metric; LCSC C1525
C2, C3, C10, C11: 10uF; C_0603_1608Metric; LCSC C96446
C4: 10uF; C_1206_3216Metric; LCSC C13585
C5: 0.1uF; C_0603_1608Metric; LCSC C14663
C7, C8: 22uF; C_0805_2012Metric; LCSC C45783
C14, C15, C19, C20: 10uF; C_0402_1005Metric; LCSC C15525
C16: 1uF; C_0402_1005Metric; LCSC C52923
D1, D2: Diode; D_SMA; LCSC C8678
D3: PESD1CAN,215; SOT95P230X110-3N; Manufacturer_Part_Number PESD1CAN,215; Mouser Part Number 771-PESD1CAN-T/R
H1, H2, H3, H4: MountingHole; Keystone_24881; LCSC C20613634
IC1: PAM2804AAB010; SOT95P280X100-5N; Manufacturer_Part_Number PAM2804AAB010; Mouser Part Number 621-PAM2804AAB010
J1: AFC01-S50FCA-00; AFC01S50FCA00; Manufacturer_Part_Number AFC01-S50FCA-00; LCSC C262676
J2: 4-Pin to Car; JST_XH_B4B-XH-A_1x04_P2.50mm_Vertical; LCSC N/A
L1: 4.7uH; L_1008_2520Metric; LCSC C5832360
L2: 15uH; L_Changjiang_FNR5040S; LCSC C167969
R1: 100k; R_0402_1005Metric; LCSC C25741
R2: 1R; R_0603_1608Metric; LCSC C22936
R3: 10R; R_0603_1608Metric; LCSC C22859
R4, R5: 5.1k; R_0402_1005Metric; LCSC C25905
R6: 51k; R_0402_1005Metric; LCSC C25794
R7, R8, R10, R11, R12: 10k; R_0402_1005Metric; LCSC C25744
R9: 1k; R_0603_1608Metric; LCSC C21190
S2: Push Button; SW_PTS526_SM08_SMTR2_LFS; PARTREV 20 mar 19; LCSC C2689521
U1: PLMR54410DBVR; U_SOT-23_TEX; LCSC C3200265
U2: AMS1117-3.3; SOT-223-3_TabPin2; LCSC C6186
U3: ESP32-S3-WROOM-1; LCSC C2913205
U4: SN65HVD230; SOIC-8_3.9x4.9mm_P1.27mm; LCSC C12084
USB1: USB-C Port; USB_C_Receptacle_G-Switch_GT-USB-7010ASV; LCSC C2988369

Connections:
+3.3V: C8.1, C9.1, C13.1, C14.1, C15.1, C17.1, C18.1, C19.1, C20.1, C21.1, J1.7, J1.8, J1.35, J1.40, J1.41, J1.42, R8.2, R9.1, R10.1, R11.1, U2.2 (VO), U3.2 (3V3), U4.3 (VCC)
+5V: C1.1, C2.1, C7.1, C10.1, C11.1, C12.1, D1.1 (K), IC1.4 (VIN), L2.1, R6.1, U2.3 (VI)
+12V: C4.1, C5.1, D2.1 (K), U1.4 (EN), U1.5 (VIN)
/12V_Car: D2.2 (A), J2.4
/CAN_RS: R12.1, U4.8 (Rs)
/CB: C6.2, U1.1 (CB)
/ESP_BOOT: R9.2, S2.1, S2.2, U3.27 (IO0)
/ESP_EN: C16.2, R8.1, U3.3 (EN)
/FB: R6.2, R7.1, U1.3 (FB)
/P1_CC1: R5.1, USB1.A5 (CC1)
/P1_CC2: R4.2, USB1.B5 (CC2)
/P1_VBUS: D1.2 (A), USB1.A4 (VBUS), USB1.A9 (VBUS), USB1.B4 (VBUS), USB1.B9 (VBUS)
/SW: C6.1, L2.2, U1.6 (SW)
BL_CTRL: IC1.1 (EN), R1.1, U3.18 (IO10)
CANH: D3.1 (CATHODE_1), J2.2, U4.7 (CANH)
CANL: D3.2 (CATHODE_2), J2.3, U4.6 (CANL)
CAN_RXI: U3.25 (IO48), U4.4 (R)
CAN_TX0: U3.24 (IO47), U4.1 (D)
ESP_USB_N: U3.13 (USB_D-), USB1.A7 (D-), USB1.B7 (D-)
ESP_USB_P: U3.14 (USB_D+), USB1.A6 (D+), USB1.B6 (D+)
GND: C1.2, C2.2, C3.2, C4.2, C5.2, C7.2, C8.2, C9.2, C10.2, C11.2, C12.2, C13.2, C14.2, C15.2, C16.1, C17.2, C18.2, C19.2, C20.2, C21.2, D3.3 (COMMON_CATHODE), IC1.2 (GND), J1.9, J1.11, J1.12, J1.13, J1.14, J1.15, J1.16, J1.17, J1.18, J1.19, J1.20, J1.21, J1.22, J1.23, J1.24, J1.34, J1.43, J1.48, J1.49, J1.50, J2.1, R1.2, R2.2, R3.2, R4.1, R5.2, R7.2, R12.2, S2.3, S2.4, U1.2 (GND), U2.1 (GND), U3.1 (GND), U3.40 (GND), U3.41 (GND), U4.2 (GND), USB1.A1 (GND), USB1.A12 (GND), USB1.B1 (GND), USB1.B12 (GND)
LCD_CS: J1.38, U3.21 (IO13)
LCD_DC: J1.37, U3.22 (IO14)
LCD_RESET: J1.10, U3.12 (IO8)
LCD_TE: J1.39, U3.17 (IO9)
LCD_WR: J1.36, U3.23 (IO21)
LED_A: C3.1, J1.1, L1.2
LED_K: IC1.5 (VOUT/FB), J1.2, J1.3, R2.1, R3.1
unnamed: IC1.3 (SW), L1.1
PARALLEL_0: J1.32, U3.4 (IO4)
PARALLEL_1: J1.31, U3.5 (IO5)
PARALLEL_2: J1.30, U3.6 (IO6)
PARALLEL_3: J1.29, U3.7 (IO7)
PARALLEL_4: J1.28, U3.8 (IO15)
PARALLEL_5: J1.27, U3.9 (IO16)
PARALLEL_6: J1.26, U3.10 (IO17)
PARALLEL_7: J1.25, U3.11 (IO18)
TOUCH_PEN_INT: J1.46, U3.20 (IO12)
TOUCH_RESET: J1.47, U3.19 (IO11)
TOUCH_SCL: J1.44, R10.2, U3.38 (IO2)
TOUCH_SDA: J1.45, R11.2, U3.39 (IO1)

Notes on the sheet:
IM2
Car Connection
Mounting
VDDI
Display
IM1
ESP32-S3
USB-C
IM0
Voltage Regulation 5v -> 3.3v
CAN
LCD Backlight Driver
VCI
Voltage Regulation 12v -> 5v

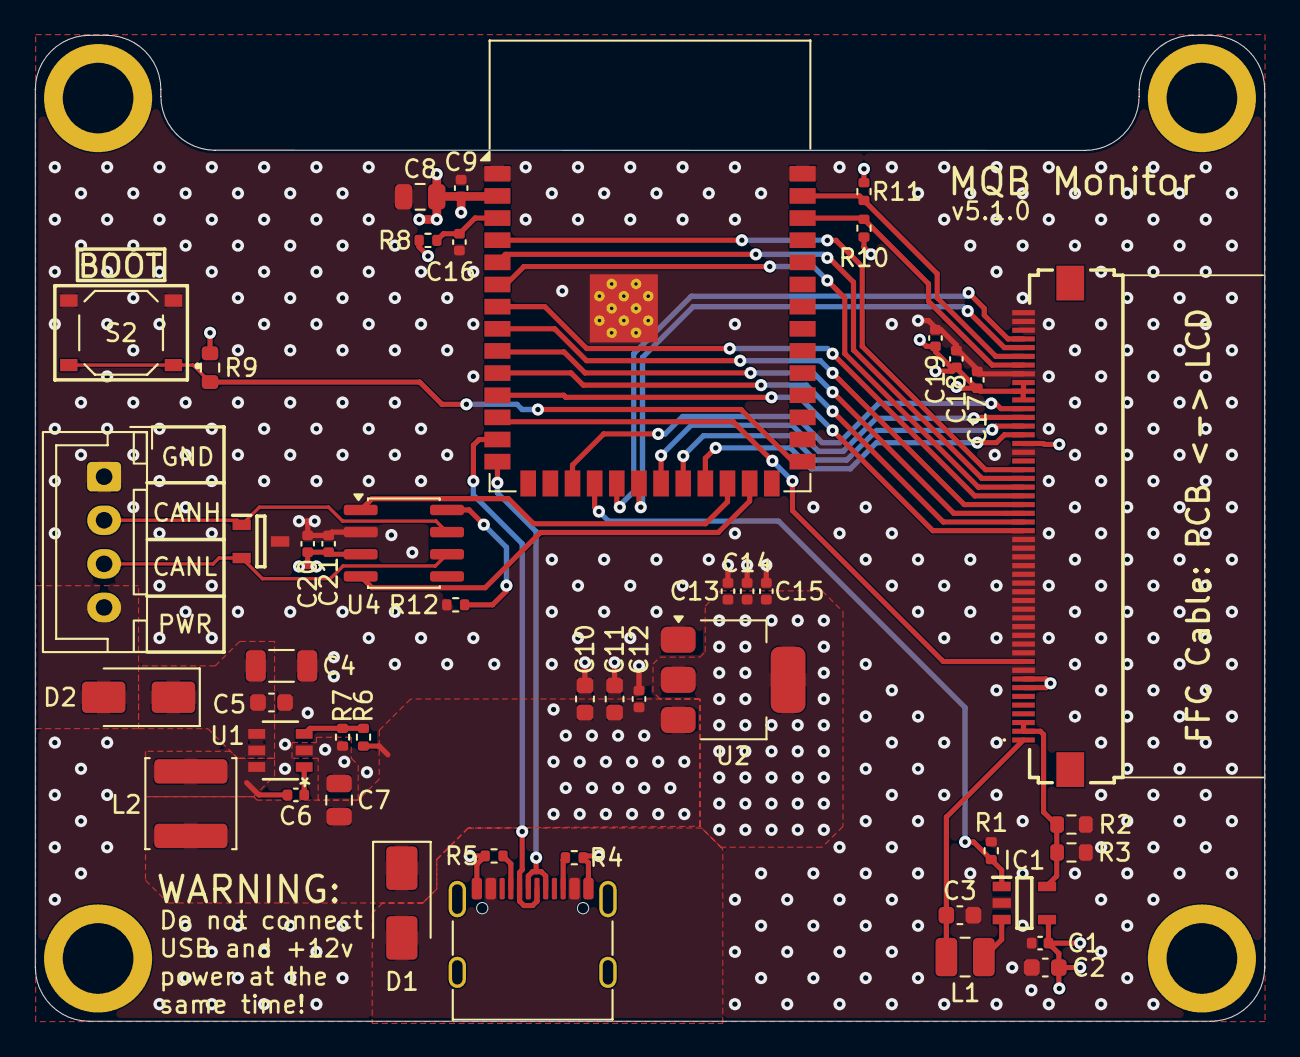
[picture p31: board MQB_Monitor.kicad_pcb from above]

Board: 4 copper layers, 70.5 x 56.5 mm, 51 parts (0 on the bottom side), 41 nets.
