akcase18/MQB_Monitor_Hardware/(commit log)

2026-07-08 Removed old files
    [MQB_Monitor_PCB_v1_0.kicad_pcb, MQB_Monitor_v2.kicad_pcb]
2026-11-11 PCB v3, v3.1
    [MQBMonitor_V3_bom.csv, MQBMonitor_V3_designators.csv, MQBMonitor_V3_positions.csv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]
2026-11-11 PCB v4, v4.1
    [MQBMonitor_V3_bom.csv, MQBMonitor_V3_positions.csv, MQBMonitor_v4.step, MQBMonitor_v4_bom.csv, MQBMonitor_v4_designators.csv, MQBMonitor_v4_positions.csv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]
2026-11-11 PCB v5.0.2
    [MQBMonitor_v5.0.0_bom.csv, MQBMonitor_v5.0.0_designators.csv, MQBMonitor_v5.0.0_positions.csv, MQBMonitor_v5.0.1_bom.csv, MQBMonitor_v5.0.1_designators.csv, MQBMonitor_v5.0.1_positions.csv, MQBMonitor_v5.0.2_bom.csv, MQBMonitor_v5.0.2_designators.csv]
2026-11-13 PCB v5.1.0
    [Display Case - Face Plate.stl, Display Case - Main Case.stl, MQBMonitor_v4.step, MQBMonitor_v4_bom.csv, MQBMonitor_v4_designators.csv, MQBMonitor_v4_positions.csv, MQBMonitor_v5.0.0_bom.csv, MQBMonitor_v5.0.0_designators.csv]
